Geowissenschaften/EXCISS/mechanical design/PSU/PSU_PCB.jpg

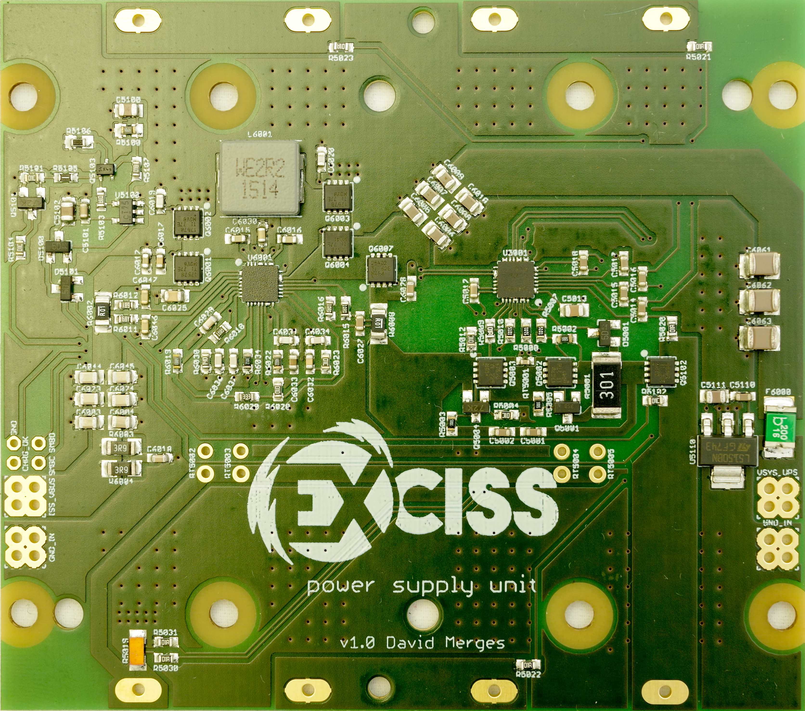
mechanical design/PSU/PSU_PCB.jpg
