Geowissenschaften/EXCISS/mechanical design/Mainboard/MB_PCB_bottom.jpg

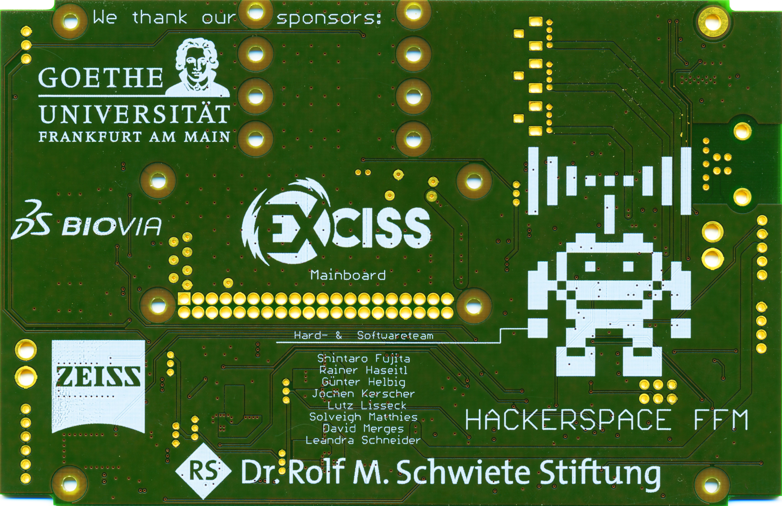
mechanical design/Mainboard/MB_PCB_bottom.jpg
