Geowissenschaften/EXCISS/README.md

# EXCISS
Experimental Chondrule Formation at the International Space Station 

Documentation is still beeing updated.

The circuit design files are online, the mechanical design files will be next.
