Geowissenschaften/EXCISS/mechanical design/HVU/HVU_PCB_trigger_back.jpg

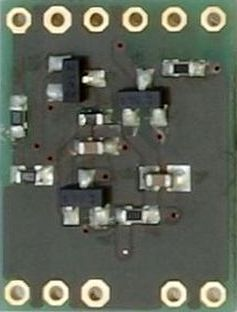
mechanical design/HVU/HVU_PCB_trigger_back.jpg
