Geowissenschaften/EXCISS/mechanical design/HVU/HVU_PCB_trigger_front.jpg

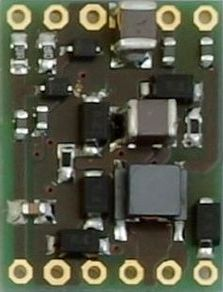
mechanical design/HVU/HVU_PCB_trigger_front.jpg
