Geowissenschaften/EXCISS/mechanical design/Mainboard/MB_PCB_top.jpg

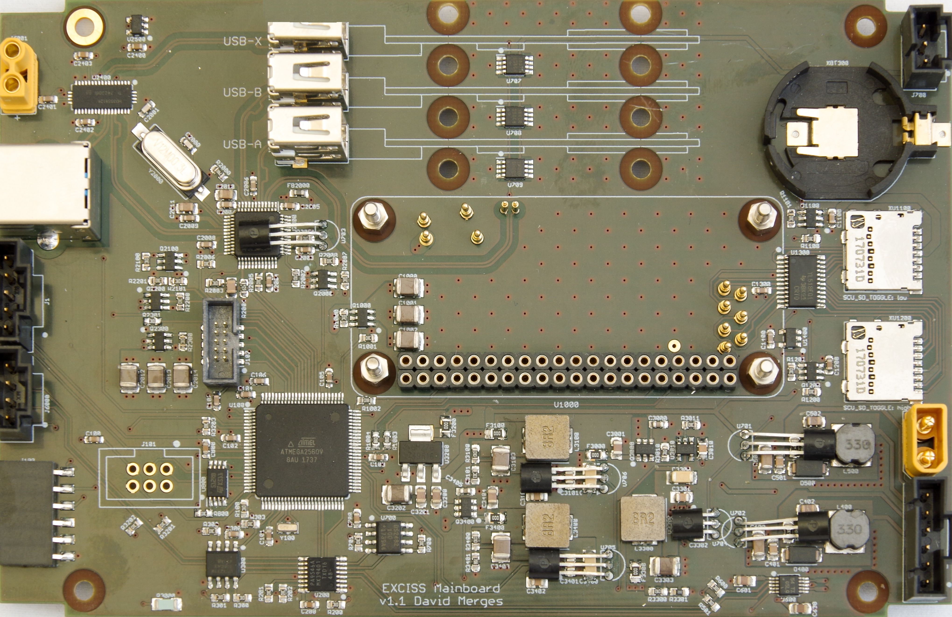
mechanical design/Mainboard/MB_PCB_top.jpg
