Geowissenschaften/EXCISS/mechanical design/SEU/SEU_Raspberry_Camera_V2.1.png

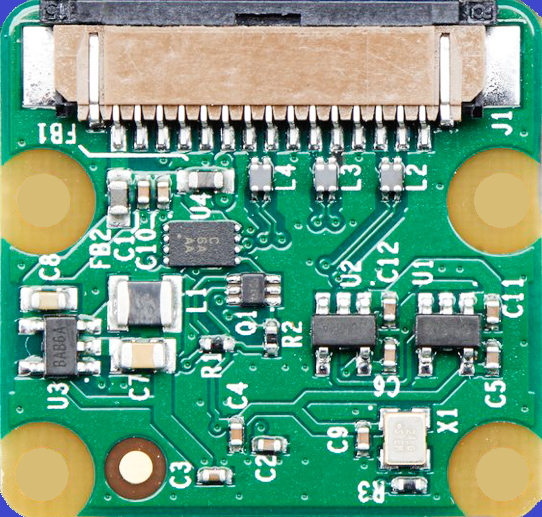
mechanical design/SEU/SEU_Raspberry_Camera_V2.1.png
