Geowissenschaften/EXCISS/(list of files, cad)

Other CAD files:
mechanical design/HVU/HVU.iam
mechanical design/HVU/HVU_1N4007.ipt
mechanical design/HVU/HVU_DC_DC_converter_(M1730CQEA06065).ipt
mechanical design/HVU/HVU_DIN_934_M3x0,5.ipt
mechanical design/HVU/HVU_PCB_power_switch.ipt
mechanical design/HVU/HVU_PCB_trigger.ipt
mechanical design/HVU/HVU_PTFE_sleeve.ipt
mechanical design/HVU/HVU_capacitor_150µF_(LGN2X151MELB50).ipt
mechanical design/HVU/HVU_capacitor_MKP4_0,1µF_(450377).ipt
mechanical design/HVU/HVU_conductor.ipt
mechanical design/HVU/HVU_diode_(BY16).ipt
mechanical design/HVU/HVU_dust.ipt
mechanical design/HVU/HVU_elekrode_tip_r.ipt
mechanical design/HVU/HVU_elekrode_tip_t.ipt
mechanical design/HVU/HVU_elektrode_Cu.ipt
mechanical design/HVU/HVU_ferrit_cable_core_(28B0773-050).ipt
mechanical design/HVU/HVU_ignition_coil.ipt
mechanical design/HVU/HVU_ignition_coil_stud.ipt
mechanical design/HVU/HVU_resistor_1M5_(VR25000001504JA100).ipt
mechanical design/HVU/HVU_resistor_2M2_(VR25000002204JA100).ipt
mechanical design/HVU/HVU_resistor_5M1_(VR25000005104JA100).ipt
mechanical design/HVU/HVU_resistor_WHS7_68R.ipt
mechanical design/HVU/HVU_sample_chamber.iam
mechanical design/HVU/HVU_sample_chamber.ipt
mechanical design/HVU/HVU_sample_chamber_dummy.ipt
mechanical design/HVU/HVU_sample_chamber_half.iam
mechanical design/HVU/HVU_sample_chamber_half.ipt
mechanical design/HVU/HVU_sample_chamber_mount_minus.ipt
mechanical design/HVU/HVU_sample_chamber_mount_plus.ipt
mechanical design/HVU/HVU_schunt.ipt
mechanical design/HVU/HVU_spark.ipt
mechanical design/HVU/HVU_standoff_(DA_40MM).ipt
mechanical design/HVU/HVU_thyristor(TN2540-800G-TR).ipt
mechanical design/HVU/HVU_wires_Carc.ipt
mechanical design/HVU/HVU_wires_Darc.ipt
mechanical design/HVU/HVU_wires_diodes.ipt
mechanical design/HVU/HVU_wires_resistor.ipt
mechanical design/HVU/HVU_wires_resistor_WHS7.ipt
mechanical design/Mainboard/MB_DIN_934_M2,5.ipt
mechanical design/Mainboard/MB_DIN_EN_ISO_1207_M2,5x6.ipt
mechanical design/Mainboard/MB_Keystone_1070.ipt
mechanical design/Mainboard/MB_MOLEX_705430002.ipt
mechanical design/Mainboard/MB_MOLEX_705430003.ipt
mechanical design/Mainboard/MB_MOLEX_705430004.ipt
mechanical design/Mainboard/MB_MOLEX_705430005.ipt
mechanical design/Mainboard/MB_RaspberryPiZeroW.ipt
mechanical design/Mainboard/MB_USB_3B_connector.ipt
mechanical design/Mainboard/MB_USB_A_B.ipt
mechanical design/Mainboard/MB_USB_X.ipt
mechanical design/Mainboard/MB_USB_connector.ipt
mechanical design/Mainboard/MB_USB_heatspreader_1.ipt
mechanical design/Mainboard/MB_USB_heatspreader_2.ipt
mechanical design/Mainboard/MB_XT30U_female_(1460539 ).ipt
mechanical design/Mainboard/MB_XT30U_male_(1460540).ipt
mechanical design/Mainboard/MB_standoff_(1466814)_shortend.ipt
mechanical design/NanoLab/NanoLab_CubeDeckel_1.ipt
mechanical design/NanoLab/NanoLab_CubeDeckel_2.ipt
mechanical design/PSU/PSU_18650_Cu_spacer.ipt
mechanical design/PSU/PSU_AS_1427_M3x5.ipt
mechanical design/PSU/PSU_PCB.ipt
mechanical design/PSU/PSU_battery_retaining_plate.ipt
mechanical design/PSU/PSU_dual_THM_battery_holder_long.ipt
mechanical design/PSU/PSU_standoff_(DA_5MM).ipt
mechanical design/PSU/PSU_standoff_(DI_20MM).ipt
mechanical design/SEU/SEU.iam
mechanical design/SEU/SEU_LINOS_Microbench_rod_(G061210000).ipt
mechanical design/SEU/SEU_Luxeon_Rebel_Star_backlight.ipt
mechanical design/SEU/SEU_Luxeon_Rebel_Star_frontlight.ipt
mechanical design/SEU/SEU_Raspberry_Camera_V2.1.ipt
mechanical design/SEU/SEU_ZEISS_EC_Epiplan-Neofluar_(422320-9900-000).ipt
mechanical design/SEU/SEU_ZEISS_tubus_lense_(423606-8031).ipt
mechanical design/SEU/SEU_backlight_diffusor_ppma.ipt
mechanical design/SEU/SEU_camera_mount_(G061008000).ipt
mechanical design/SEU/SEU_led_mount_backlight_(G061008000).ipt
mechanical design/SEU/SEU_led_mount_frontlight.ipt
mechanical design/SEU/SEU_lense_mount_(G061042000).ipt
mechanical design/SEU/SEU_mounting_fixture_back(G061042000).ipt
mechanical design/SEU/SEU_mounting_fixture_front(G061042000).ipt
mechanical design/SEU/SEU_retaining_plate_HVU.ipt
mechanical design/SEU/SEU_threaded_insert_M3.ipt
mechanical design/SEU/SEU_threaded_insert_insulation.ipt
mechanical design/Screws/ANSI_4-40_UNC.ipt
mechanical design/Screws/DIN_963_M2,5x5.ipt
mechanical design/Screws/DIN_963_M3x5.ipt
mechanical design/Screws/DIN_963_M3x6.ipt
