Geowissenschaften/EXCISS/PCB/EXCISS HVU.pdf

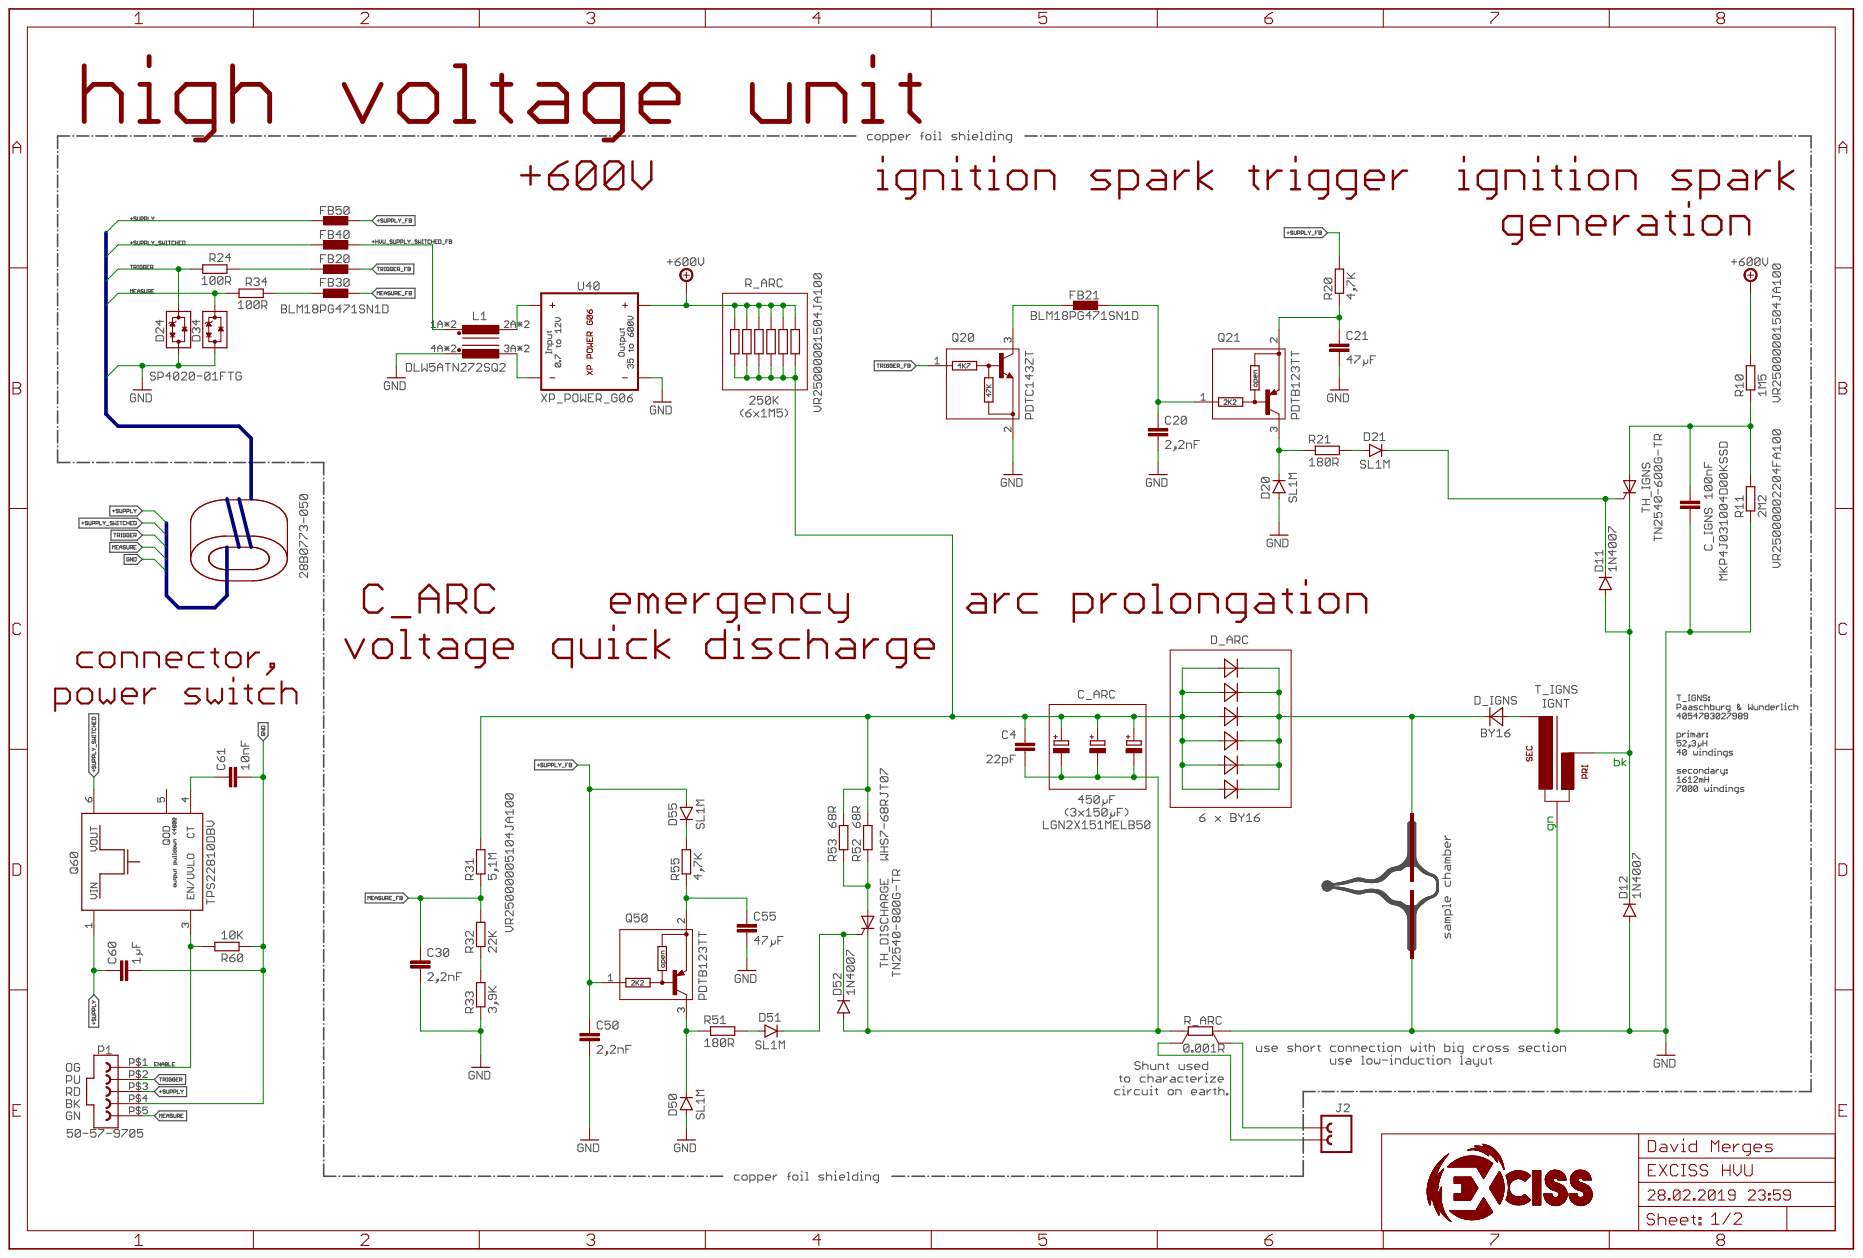
[picture p7: page 1]
