Geowissenschaften/EXCISS/PCB/EXCISS PSU.pdf

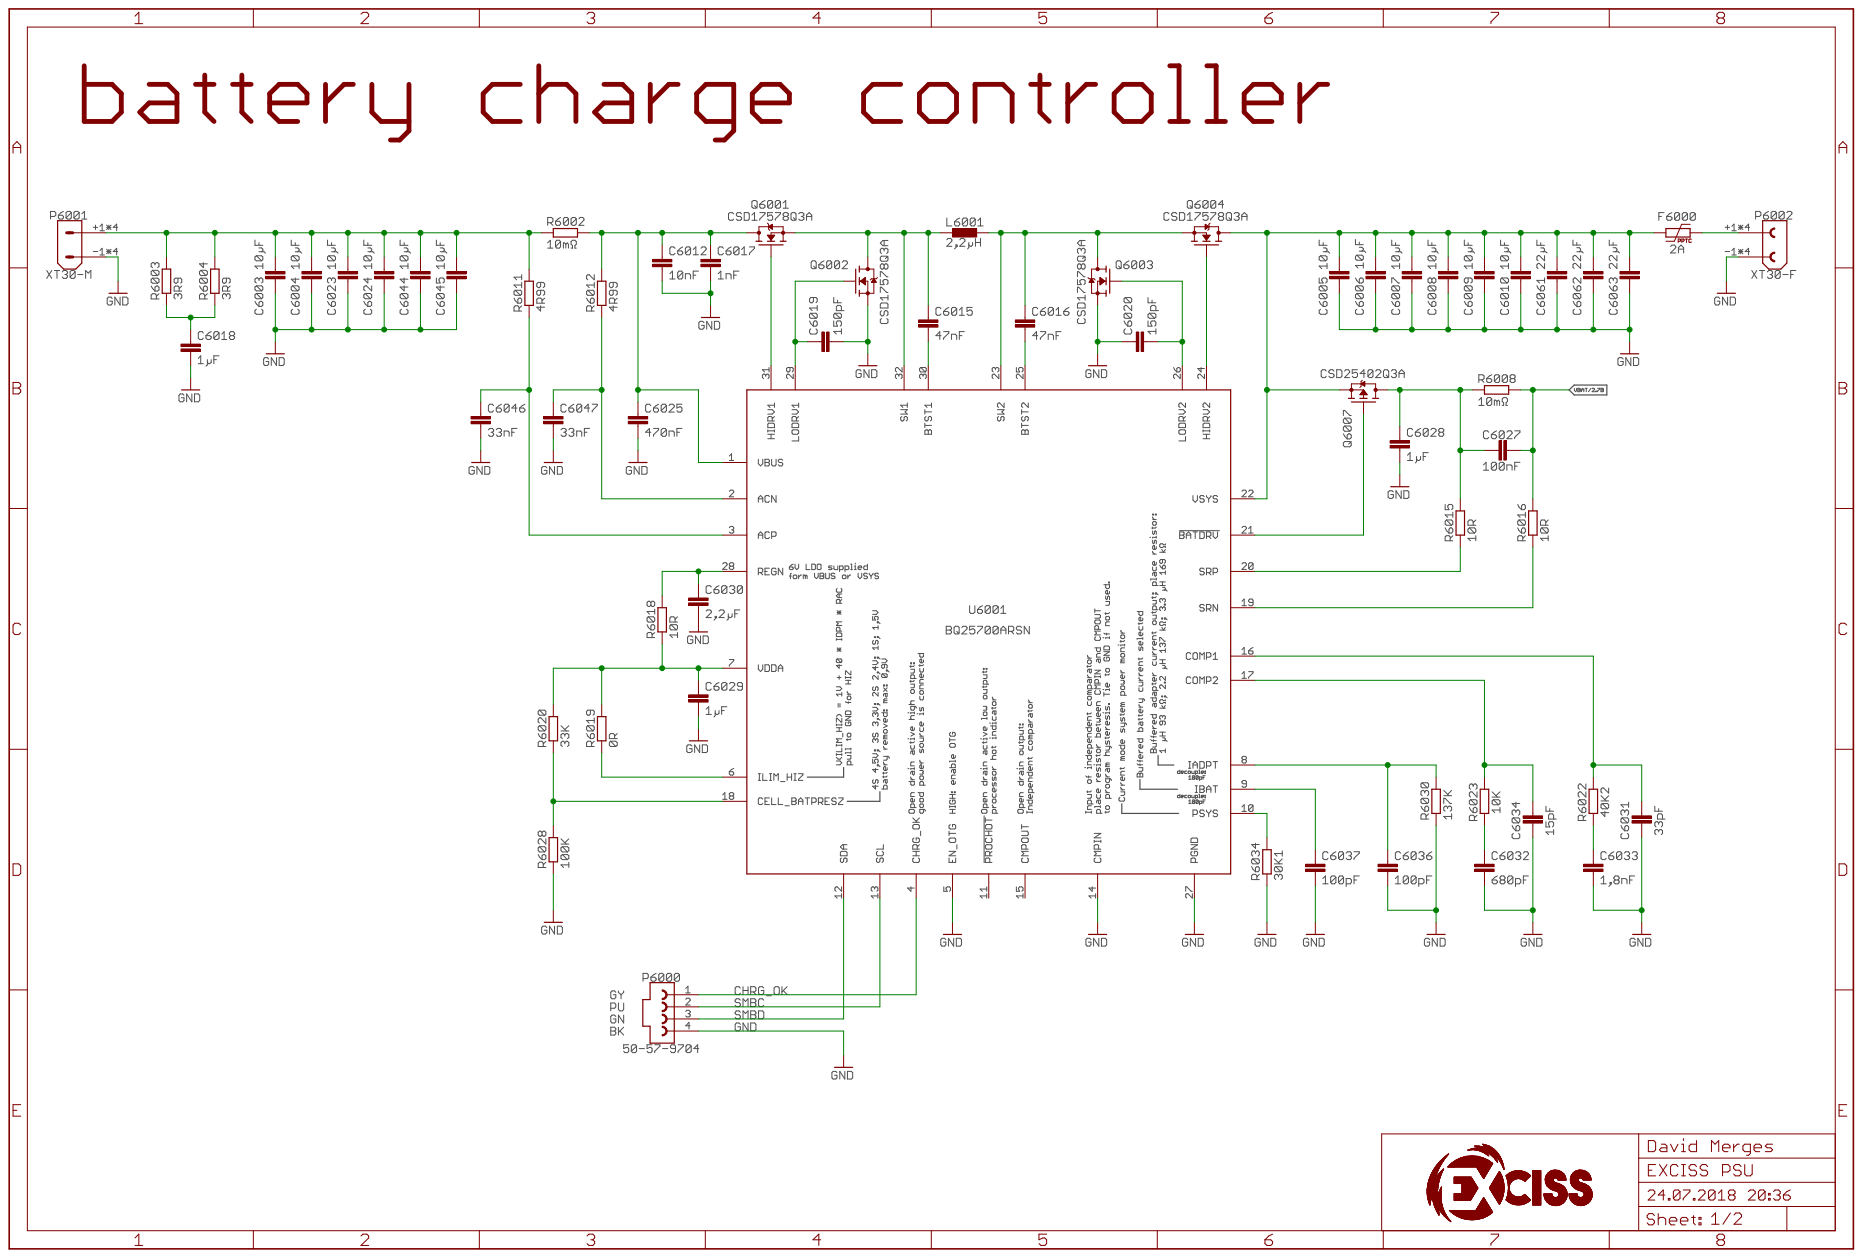
[picture p13: page 1]

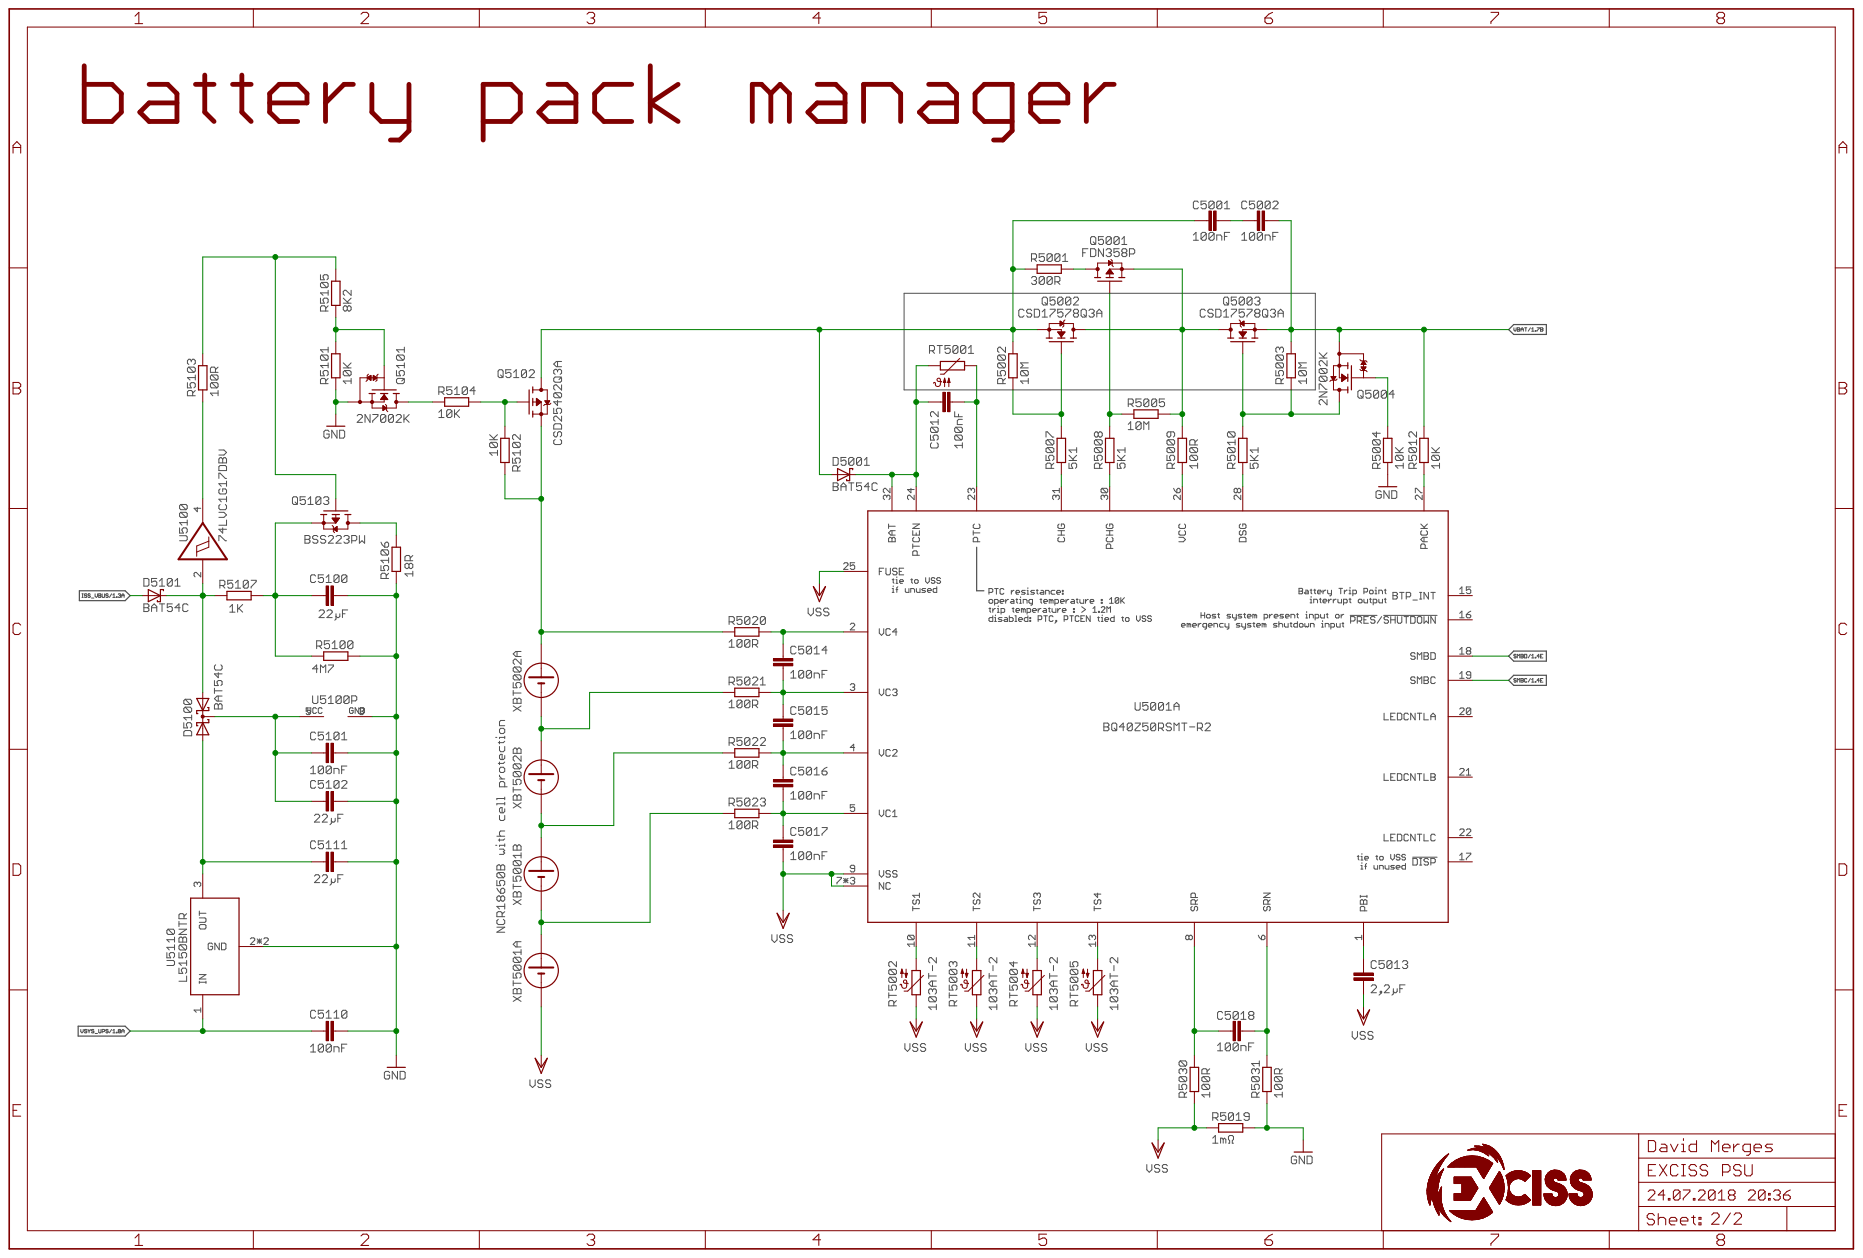
[picture p14: page 2]
