Geowissenschaften/EXCISS/PCB/EXCISS SEU.pdf

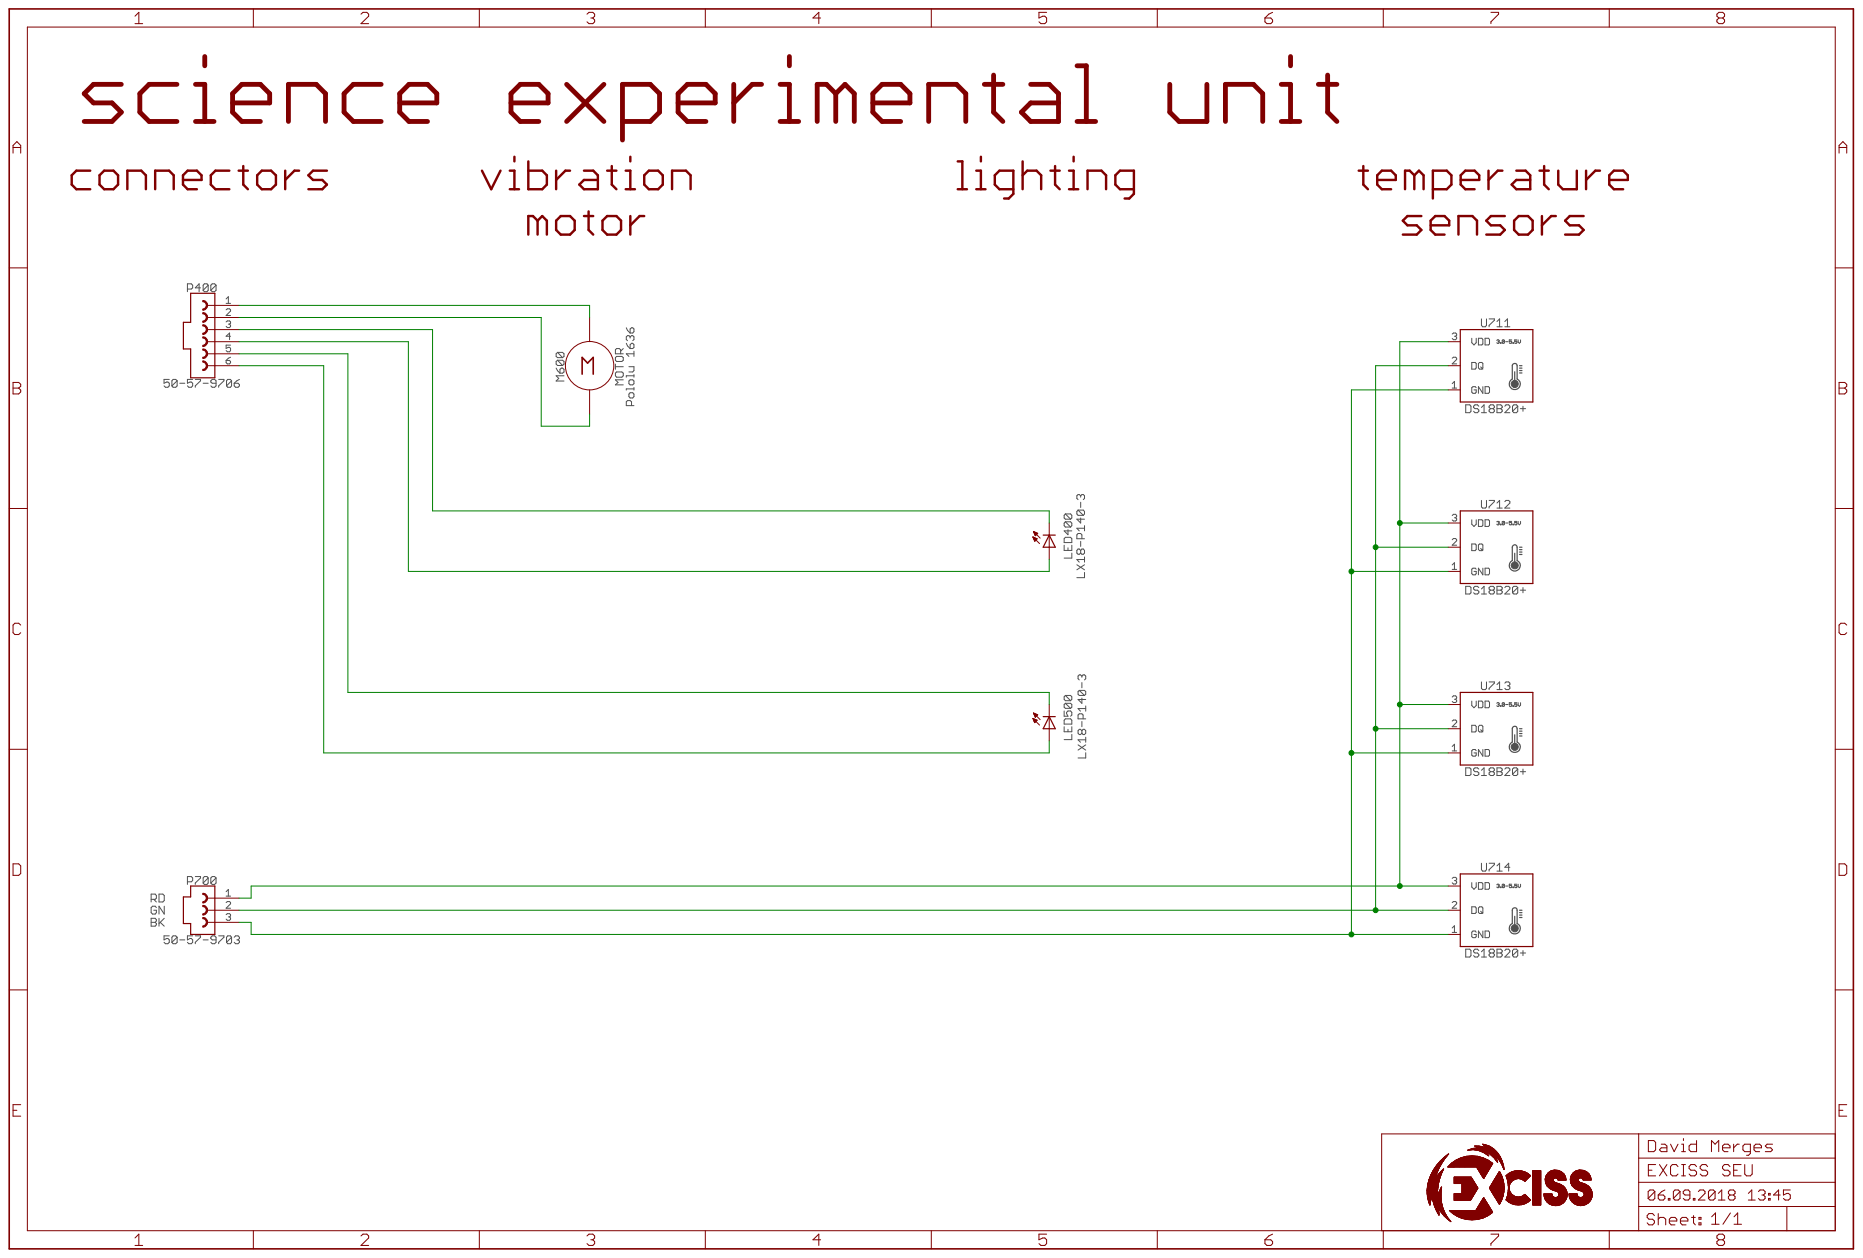
[picture p15: page 1]
