Geowissenschaften/EXCISS/PCB/EXCISS PSU.brd

## EAGLE design PCB/EXCISS PSU.brd (2019-06-11)

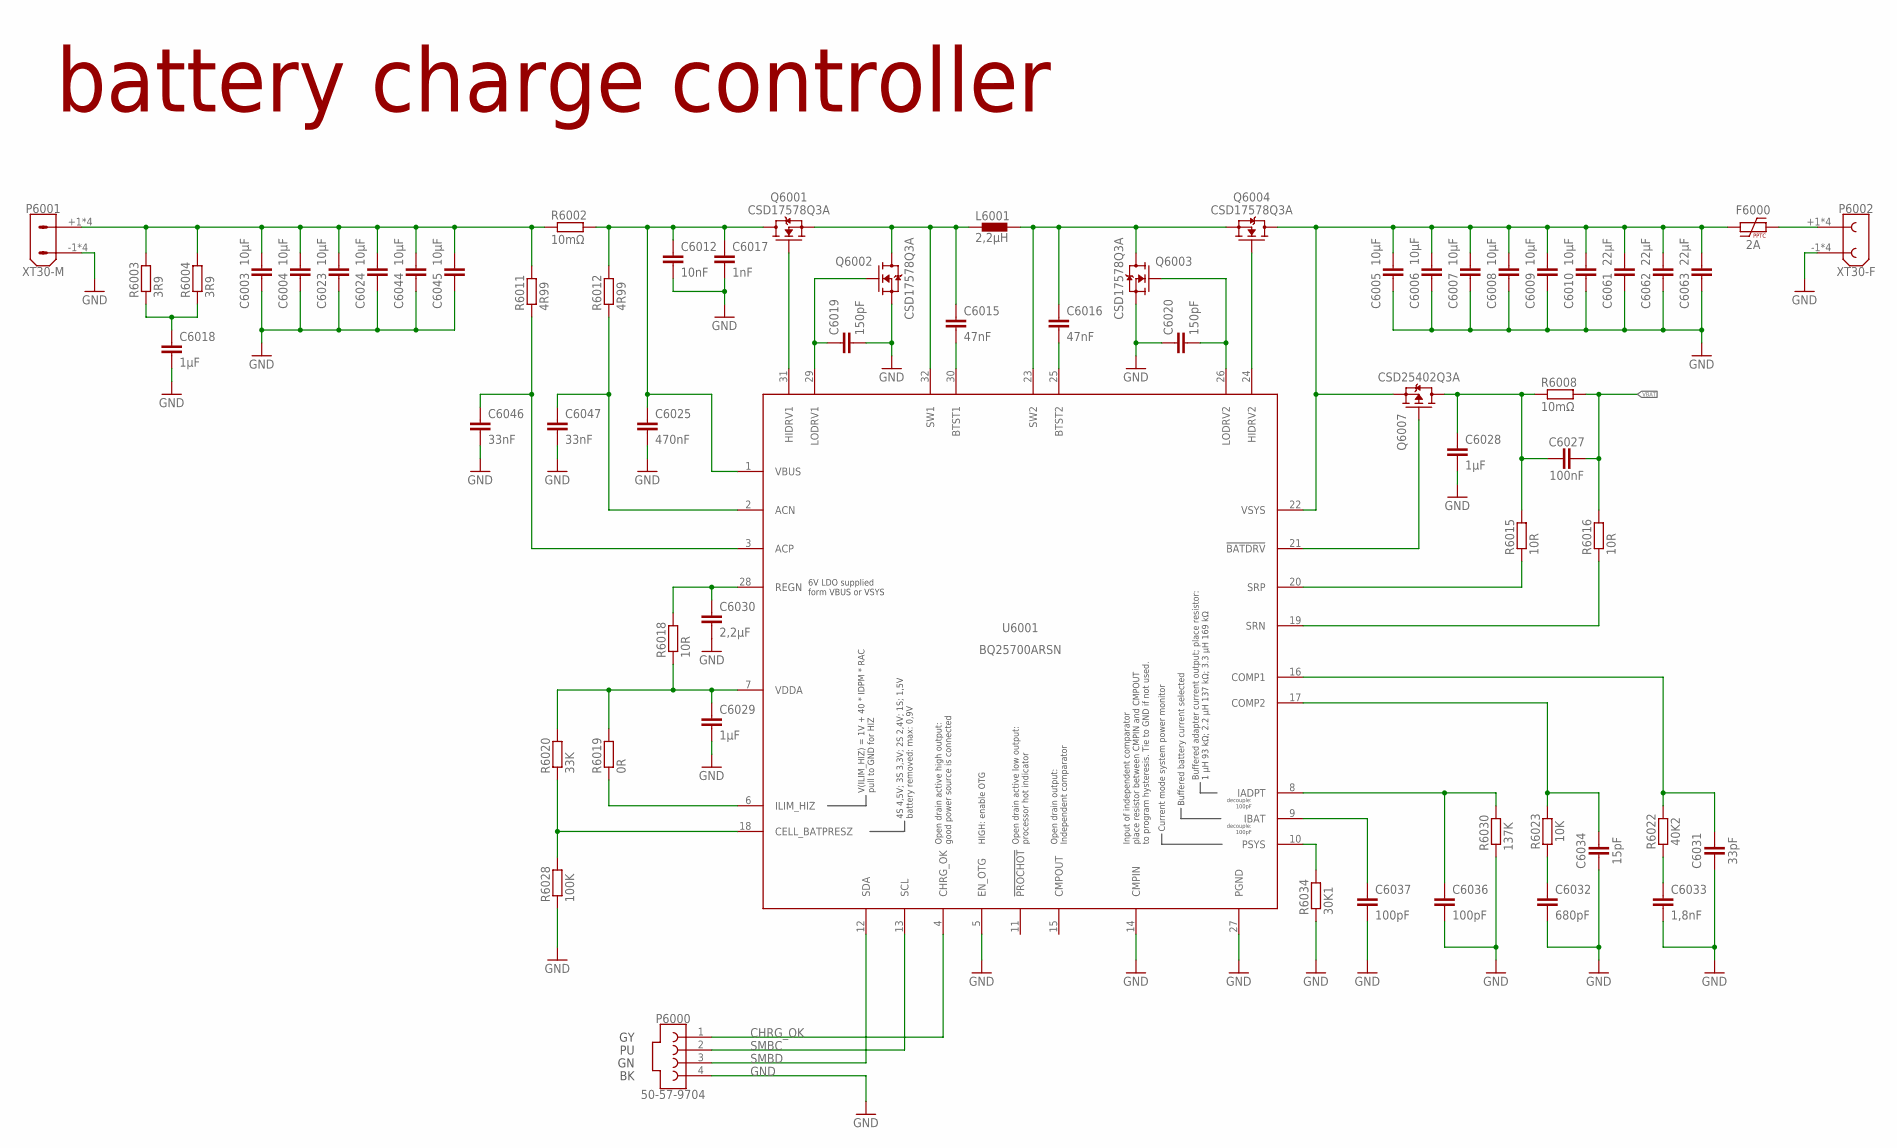
[picture p16: schematic EXCISS PSU.sch, sheet 1]

Parts:
C6003, C6004, C6005, C6006, C6007, C6008, C6009, C6010, C6023, C6024, C6044, C6045: 10µF; C0805
C6012: 10nF; C0603
C6015, C6016: 47nF; C0603
C6017: 1nF; C0603
C6018, C6028, C6029: 1µF; C0603
C6019, C6020: 150pF; C0603
C6025: 470nF; C0805
C6027: 100nF; C0603
C6030: 2,2µF; C0603
C6031: 33pF; C0603
C6032: 680pF; C0603
C6033: 1,8nF; C0603
C6034: 15pF; C0603
C6036, C6037: 100pF; C0603
C6046, C6047: 33nF; C0603
C6061, C6062, C6063: 22µF; C1210
F6000: 2A; PTC_1812
L6001: 2,2µH; 8030
P6000: 50-57-9704; RENAME-SIGNAL
P6001: XT30-M; RENAME_XT-CONNECTOR
P6002: XT30-F; RENAME_XT-CONNECTOR
Q6001, Q6002, Q6003, Q6004: CSD17578Q3A; Q3A
Q6007: CSD25402Q3A; Q3A
R6002, R6008: 10mΩ; R1206
R6003, R6004: 3R9; R1206
R6011, R6012: 4R99; R0603
R6015, R6016, R6018: 10R; R0603
R6019: 0R; R0603
R6020: 33K; R0603
R6022: 40K2; R0603
R6023: 10K; R0603
R6028: 100K; R0603
R6030: 137K; R0603
R6034: 30K1; R0603
U6001: BQ25700ARSN; RSN(S-PWQFN-N32)

Connections:
CHRG_OK: P6000.1, U6001.4 (CHRG_OK)
GND: C6003.2, C6004.2, C6005.2, C6006.2, C6007.2, C6008.2, C6009.2, C6010.2, C6012.2, C6017.2, C6018.2, C6019.2, C6020.1, C6023.2, C6024.2, C6025.2, C6028.2, C6029.2, C6030.2, C6031.2, C6032.2, C6033.2, C6034.2, C6036.2, C6037.2, C6044.2, C6045.2, C6046.2, C6047.2, C6061.2, C6062.2, C6063.2, P6000.4, P6001.-1 (-), P6001.-2 (-), P6001.-3 (-), P6001.-4 (-), P6002.-1 (-), P6002.-2 (-), P6002.-3 (-), P6002.-4 (-), Q6002.1 (S), Q6002.2 (S), Q6002.3 (S), Q6003.1 (S), Q6003.2 (S), Q6003.3 (S), R6028.1, R6030.1, R6034.1, U6001.5 (EN_OTG), U6001.14 (CMPIN), U6001.27 (PGND), U6001.TP0 (GND), U6001.TP1 (GND), U6001.TP2 (GND), U6001.TP3 (GND), U6001.TP4 (GND), U6001.TP5 (GND), U6001.TP6 (GND), U6001.TP7 (GND), U6001.TP8 (GND), U6001.TP9 (GND); also elsewhere on the board
ISS_VBUS: C6003.1, C6004.1, C6023.1, C6024.1, C6044.1, C6045.1, P6001.+1 (+), P6001.+2 (+), P6001.+3 (+), P6001.+4 (+), R6002.1, R6003.2, R6004.2, R6011.2; also elsewhere on the board
unnamed: C6018.1, R6003.1, R6004.1
unnamed: Q6007.4 (G), U6001.21 (!BATDRV)
unnamed: C6032.1, R6023.1
unnamed: R6015.1, U6001.20 (SRP)
unnamed: C6027.1, C6028.1, Q6007.1 (D), Q6007.2 (D), Q6007.3 (D), R6008.1, R6015.2
unnamed: R6016.1, U6001.19 (SRN)
unnamed: Q6001.4 (G), U6001.31 (HIDRV1)
unnamed: C6019.1, Q6002.4 (G), U6001.29 (LODRV1)
unnamed: C6015.2, U6001.30 (BTST1)
unnamed: C6016.1, L6001.P$2 (2), Q6003.TP0 (D), Q6003.TP1 (D), Q6003.TP2 (D), Q6003.TP3 (D), Q6003.TP4 (D), Q6003.TP5 (D), Q6003.TP6 (D), Q6003.TP7 (D), Q6004.1 (S), Q6004.2 (S), Q6004.3 (S), U6001.23 (SW2)
unnamed: C6034.1, R6023.2, U6001.17 (COMP2)
unnamed: C6036.1, R6030.2, U6001.8 (IADPT)
unnamed: R6019.1, U6001.6 (ILIM_HIZ)
unnamed: C6033.1, R6022.1
unnamed: C6020.2, Q6003.4 (G), U6001.26 (LODRV2)
unnamed: Q6004.4 (G), U6001.24 (HIDRV2)
unnamed: C6031.1, R6022.2, U6001.16 (COMP1)
unnamed: C6015.1, L6001.P$1 (1), Q6001.1 (S), Q6001.2 (S), Q6001.3 (S), Q6002.TP0 (D), Q6002.TP1 (D), Q6002.TP2 (D), Q6002.TP3 (D), Q6002.TP4 (D), Q6002.TP5 (D), Q6002.TP6 (D), Q6002.TP7 (D), U6001.32 (SW1)
unnamed: R6034.2, U6001.10 (PSYS)
unnamed: C6037.1, U6001.9 (IBAT)
unnamed: C6046.1, R6011.1, U6001.3 (ACP)
unnamed: C6047.1, R6012.1, U6001.2 (ACN)
unnamed: C6016.2, U6001.25 (BTST2)
unnamed: C6012.1, C6017.1, C6025.1, Q6001.TP0 (D), Q6001.TP1 (D), Q6001.TP2 (D), Q6001.TP3 (D), Q6001.TP4 (D), Q6001.TP5 (D), Q6001.TP6 (D), Q6001.TP7 (D), R6002.2, R6012.2, U6001.1 (VBUS)
unnamed: R6020.1, R6028.2, U6001.18 (CELL_BATPRESZ)
REGN: C6030.1, R6018.2, U6001.28 (REGN)
SMBC: P6000.2, U6001.13 (SCL); also elsewhere on the board
SMBD: P6000.3, U6001.12 (SDA); also elsewhere on the board
VBAT: C6027.2, R6008.2, R6016.2; also elsewhere on the board
VDDA: C6029.1, R6018.1, R6019.2, R6020.2, U6001.7 (VDDA)
VSYS_UPS: F6000.P$3 (2), P6002.+1 (+), P6002.+2 (+), P6002.+3 (+), P6002.+4 (+); also elsewhere on the board
VSYS_UPS_PREFUSE: C6005.1, C6006.1, C6007.1, C6008.1, C6009.1, C6010.1, C6061.1, C6062.1, C6063.1, F6000.P$2 (1), Q6004.TP0 (D), Q6004.TP1 (D), Q6004.TP2 (D), Q6004.TP3 (D), Q6004.TP4 (D), Q6004.TP5 (D), Q6004.TP6 (D), Q6004.TP7 (D), Q6007.TP0 (S), Q6007.TP1 (S), Q6007.TP2 (S), Q6007.TP3 (S), Q6007.TP4 (S), Q6007.TP5 (S), Q6007.TP6 (S), Q6007.TP7 (S), U6001.22 (VSYS)

Notes on the sheet:
battery charge controller

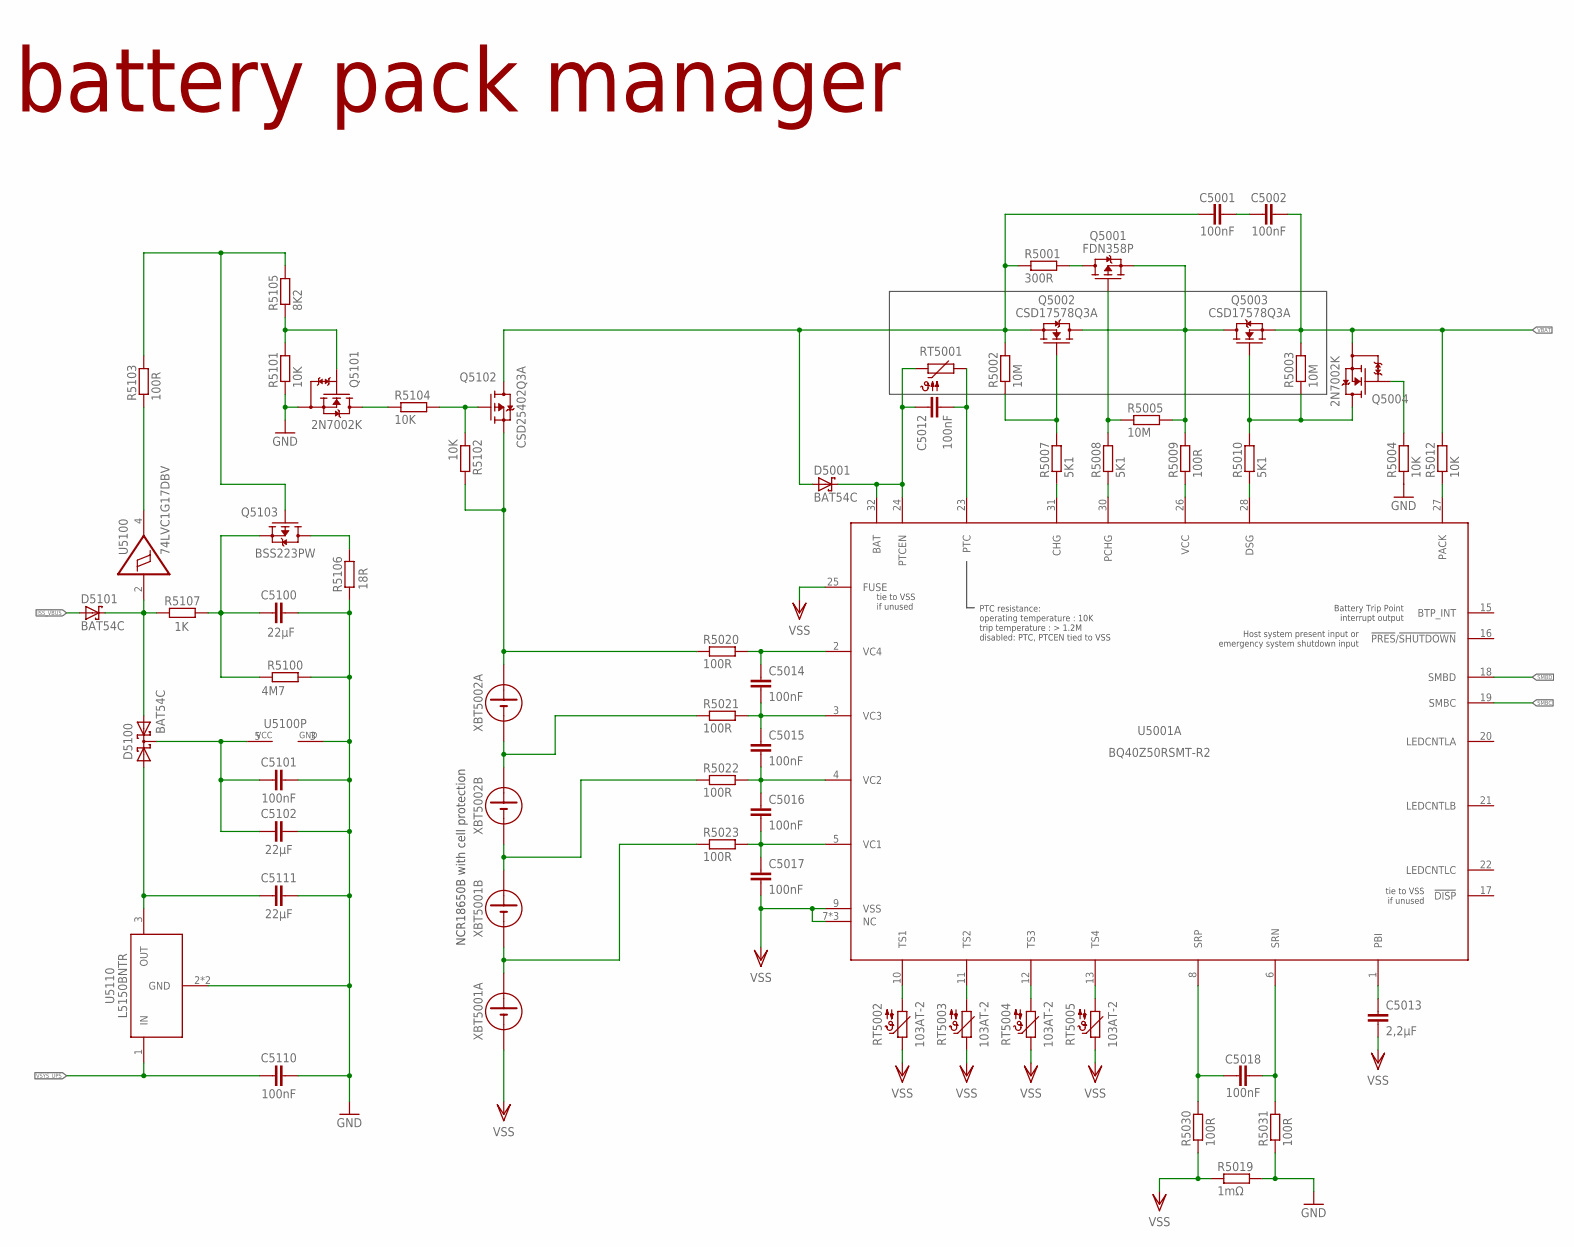
[picture p17: schematic EXCISS PSU.sch, sheet 2]

Parts:
C5001, C5002, C5012, C5014, C5015, C5016, C5017, C5018, C5101, C5110: 100nF; C0603
C5013: 2,2µF; C0805
C5100, C5102, C5111: 22µF; C0805
D5001, D5100, D5101: BAT54C; SOT23
Q5001: FDN358P; SOT23-3
Q5002, Q5003: CSD17578Q3A; Q3A
Q5004, Q5101: 2N7002K; SOT23-3
Q5102: CSD25402Q3A; Q3A
Q5103: BSS223PW; DCK(R-PDSO-G3)
R5001: 300R; R2512
R5002, R5003, R5005: 10M; R0603
R5004, R5012, R5101, R5102, R5104: 10K; R0603
R5007, R5008, R5010: 5K1; R0603
R5009, R5020, R5021, R5022, R5023, R5030, R5031, R5103: 100R; R0603
R5019: 1mΩ; R1206
R5100: 4M7; R0805
R5105: 8K2; R0603
R5106: 18R; R0805
R5107: 1K; R0603
RT5001: PRF15BB103RB6RC; 0402
RT5002, RT5003, RT5004, RT5005: 103AT-2; AT-2
U5001: BQ40Z50RSMT-R2; RSM(S-PVQFN-N32)
U5100: 74LVC1G17DBV; SOT23-5
U5110: L5150BNTR; SOT223
XBT5001, XBT5002: KEYSTONE_1049_LONG

Connections:
1P: R5023.1, XBT5001.1+ (+), XBT5001.2- (-)
2P: R5022.1, XBT5001.2+ (+), XBT5002.2- (-)
3P: R5021.1, XBT5002.1- (-), XBT5002.2+ (+)
4P: Q5102.TP0 (S), Q5102.TP1 (S), Q5102.TP2 (S), Q5102.TP3 (S), Q5102.TP4 (S), Q5102.TP5 (S), Q5102.TP6 (S), Q5102.TP7 (S), R5020.1, R5102.2, XBT5002.1+ (+)
4P_SWITCHED: C5001.1, D5001.1 (A), Q5002.1 (S), Q5002.2 (S), Q5002.3 (S), Q5102.1 (D), Q5102.2 (D), Q5102.3 (D), R5001.1, R5002.2
GND: C5100.2, C5101.2, C5102.2, C5110.2, C5111.2, Q5101.2 (S), R5004.1, R5019.2, R5031.1, R5100.1, R5101.1, R5106.2, U5100.3 (GND), U5110.2 (GND), U5110.4 (GND); also elsewhere on the board
ISS_VBUS: D5101.1 (A); also elsewhere on the board
unnamed: Q5102.4 (G), R5102.1, R5104.2
unnamed: R5103.1, U5100.4 (O)
unnamed: Q5101.1 (G), R5101.2, R5105.1
unnamed: Q5101.3 (D), R5104.1
unnamed: C5100.1, Q5103.2 (S), R5100.2, R5107.1
unnamed: R5010.1, U5001.28 (DSG)
unnamed: C5001.2, C5002.1
unnamed: Q5001.2 (S), Q5002.TP0 (D), Q5002.TP1 (D), Q5002.TP2 (D), Q5002.TP3 (D), Q5002.TP4 (D), Q5002.TP5 (D), Q5002.TP6 (D), Q5002.TP7 (D), Q5003.TP0 (D), Q5003.TP1 (D), Q5003.TP2 (D), Q5003.TP3 (D), Q5003.TP4 (D), Q5003.TP5 (D), Q5003.TP6 (D), Q5003.TP7 (D), R5005.2, R5009.2
unnamed: Q5103.3 (D), R5106.1
unnamed: Q5002.4 (G), R5002.1, R5007.2
unnamed: R5007.1, U5001.31 (CHG)
unnamed: Q5001.3 (D), R5001.2
unnamed: Q5001.1 (G), R5005.1, R5008.2
unnamed: R5009.1, U5001.26 (VCC)
unnamed: C5101.1, C5102.1, D5100.3 (CC), U5100.5 (VCC)
unnamed: Q5003.4 (G), Q5004.3 (D), R5003.1, R5010.2
unnamed: R5008.1, U5001.30 (PCHG)
unnamed: Q5004.1 (G), R5004.2
unnamed: R5012.1, U5001.27 (PACK)
unnamed: C5014.1, R5020.2, U5001.2 (VC4)
unnamed: C5014.2, C5015.1, R5021.2, U5001.3 (VC3)
unnamed: C5015.2, C5016.1, R5022.2, U5001.4 (VC2)
unnamed: C5016.2, C5017.1, R5023.2, U5001.5 (VC1)
unnamed: C5013.1, U5001.1 (PBI)
unnamed: C5012.1, D5001.3 (C), RT5001.1, U5001.24 (PTCEN), U5001.32 (BAT)
unnamed: C5012.2, RT5001.2, U5001.23 (PTC)
unnamed: C5018.2, R5031.2, U5001.6 (SRN)
unnamed: C5018.1, R5030.2, U5001.8 (SRP)
unnamed: RT5002.P$2 (2), U5001.10 (TS1)
unnamed: RT5003.P$2 (2), U5001.11 (TS2)
unnamed: RT5004.P$2 (2), U5001.12 (TS3)
unnamed: RT5005.P$2 (2), U5001.13 (TS4)
unnamed: Q5103.1 (G), R5103.2, R5105.2
unnamed: D5100.1 (A1), D5101.3 (C), R5107.2, U5100.2 (I)
OUT: C5111.1, D5100.2 (A2), U5110.3 (OUT)
SMBC: U5001.19 (SMBC); also elsewhere on the board
SMBD: U5001.18 (SMBD); also elsewhere on the board
VBAT: C5002.2, Q5003.1 (S), Q5003.2 (S), Q5003.3 (S), Q5004.2 (S), R5003.2, R5012.2; also elsewhere on the board
VSS: C5013.2, C5017.2, R5019.1, R5030.1, RT5002.P$1 (1), RT5003.P$1 (1), RT5004.P$1 (1), RT5005.P$1 (1), U5001.7 (NC), U5001.9 (VSS), U5001.14 (NC), U5001.25 (FUSE), U5001.29 (NC), U5001.TP0 (VSS), U5001.TP1 (VSS), XBT5001.1- (-)
VSYS_UPS: C5110.1, U5110.1 (IN); also elsewhere on the board

Notes on the sheet:
battery pack manager
NCR18650B with cell protection

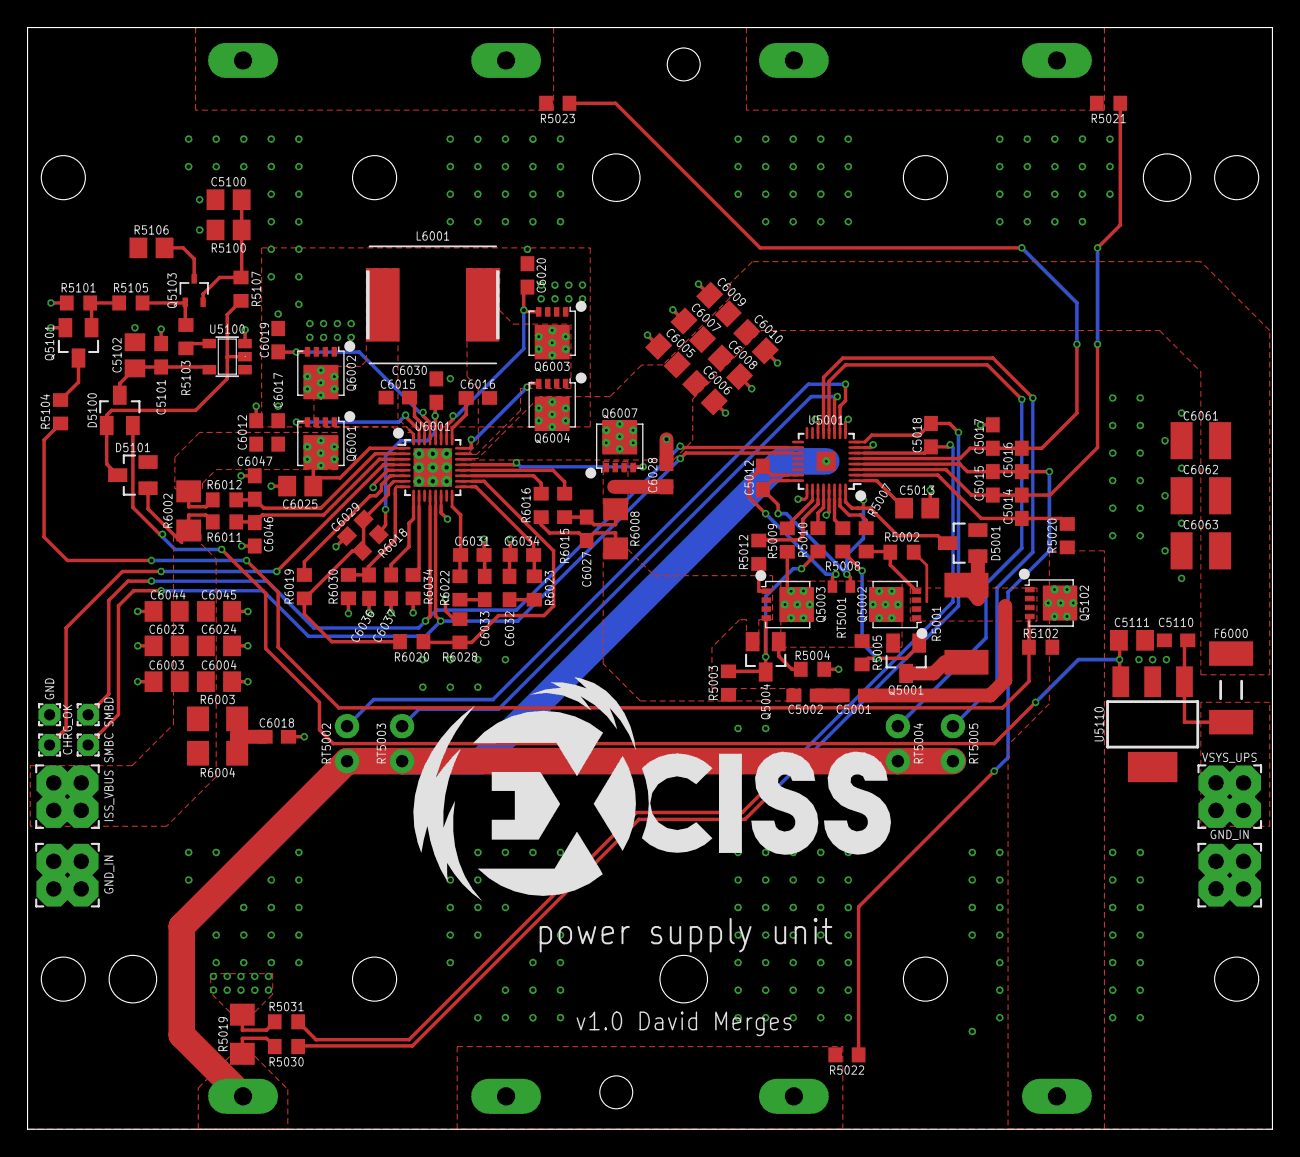
[picture p18: board EXCISS PSU.brd from above]

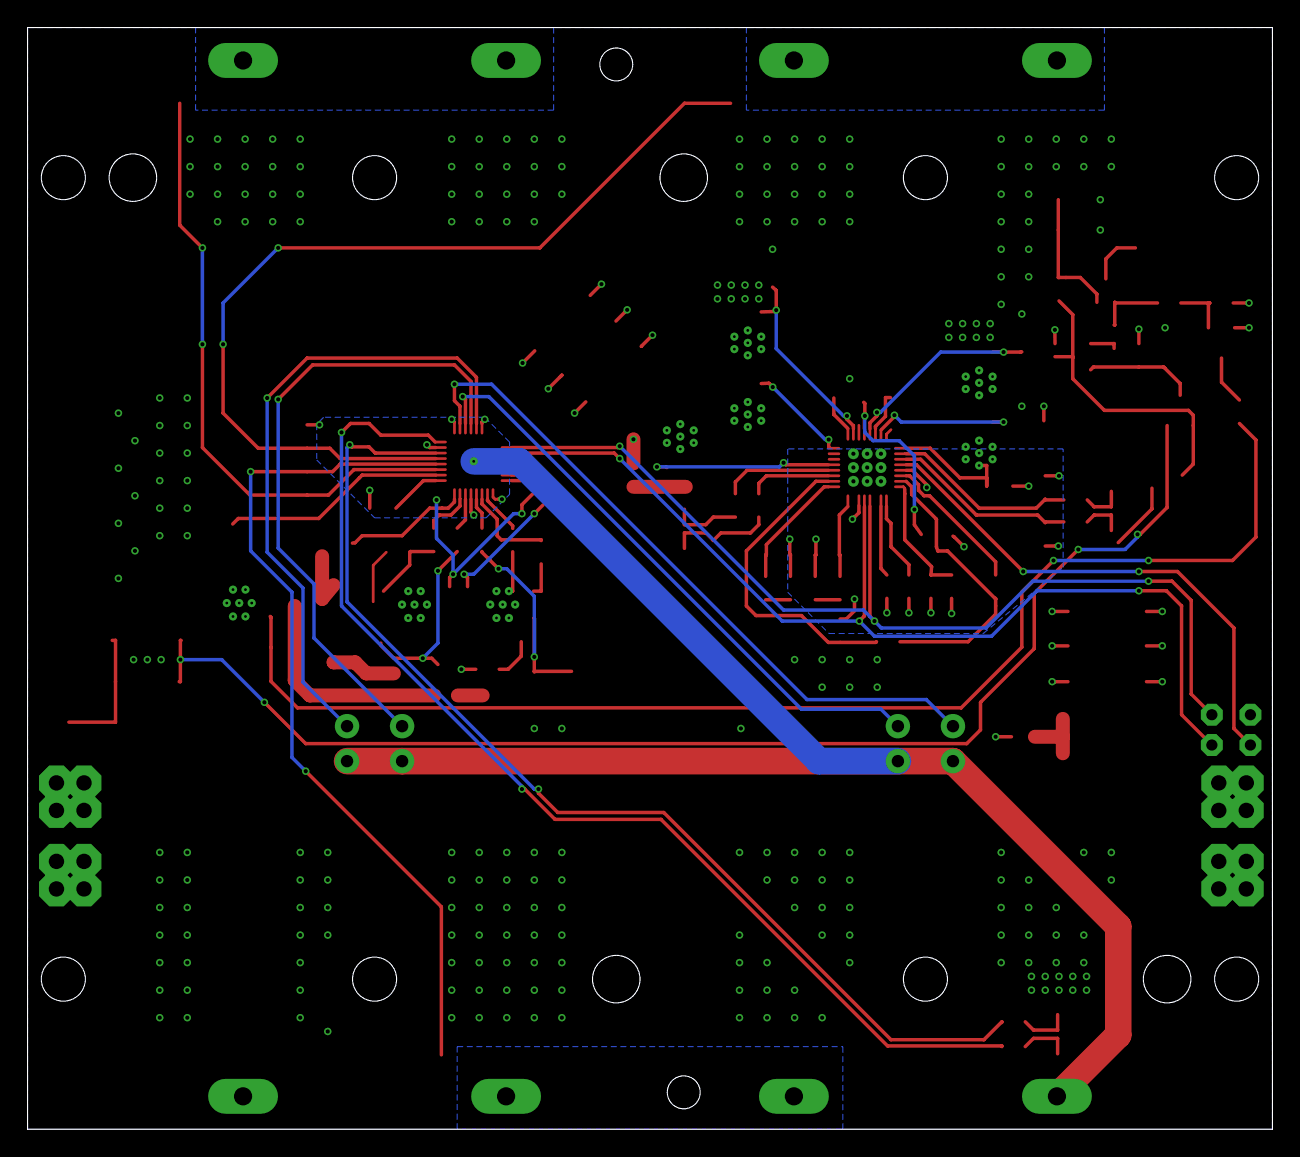
[picture p19: board EXCISS PSU.brd from below]

Board: 2 copper layers, 90.4 x 80.0 mm, 126 parts (2 on the bottom side), 76 nets.

Other parts of the board:
U$1, U$2, U$3, U$4: DRILL_M3_SPACER
U$5: LOGO_EXCISS
