Geowissenschaften/EXCISS/PCB/EXCISS Mainboard.brd

## EAGLE design PCB/EXCISS Mainboard.brd (2019-06-11)

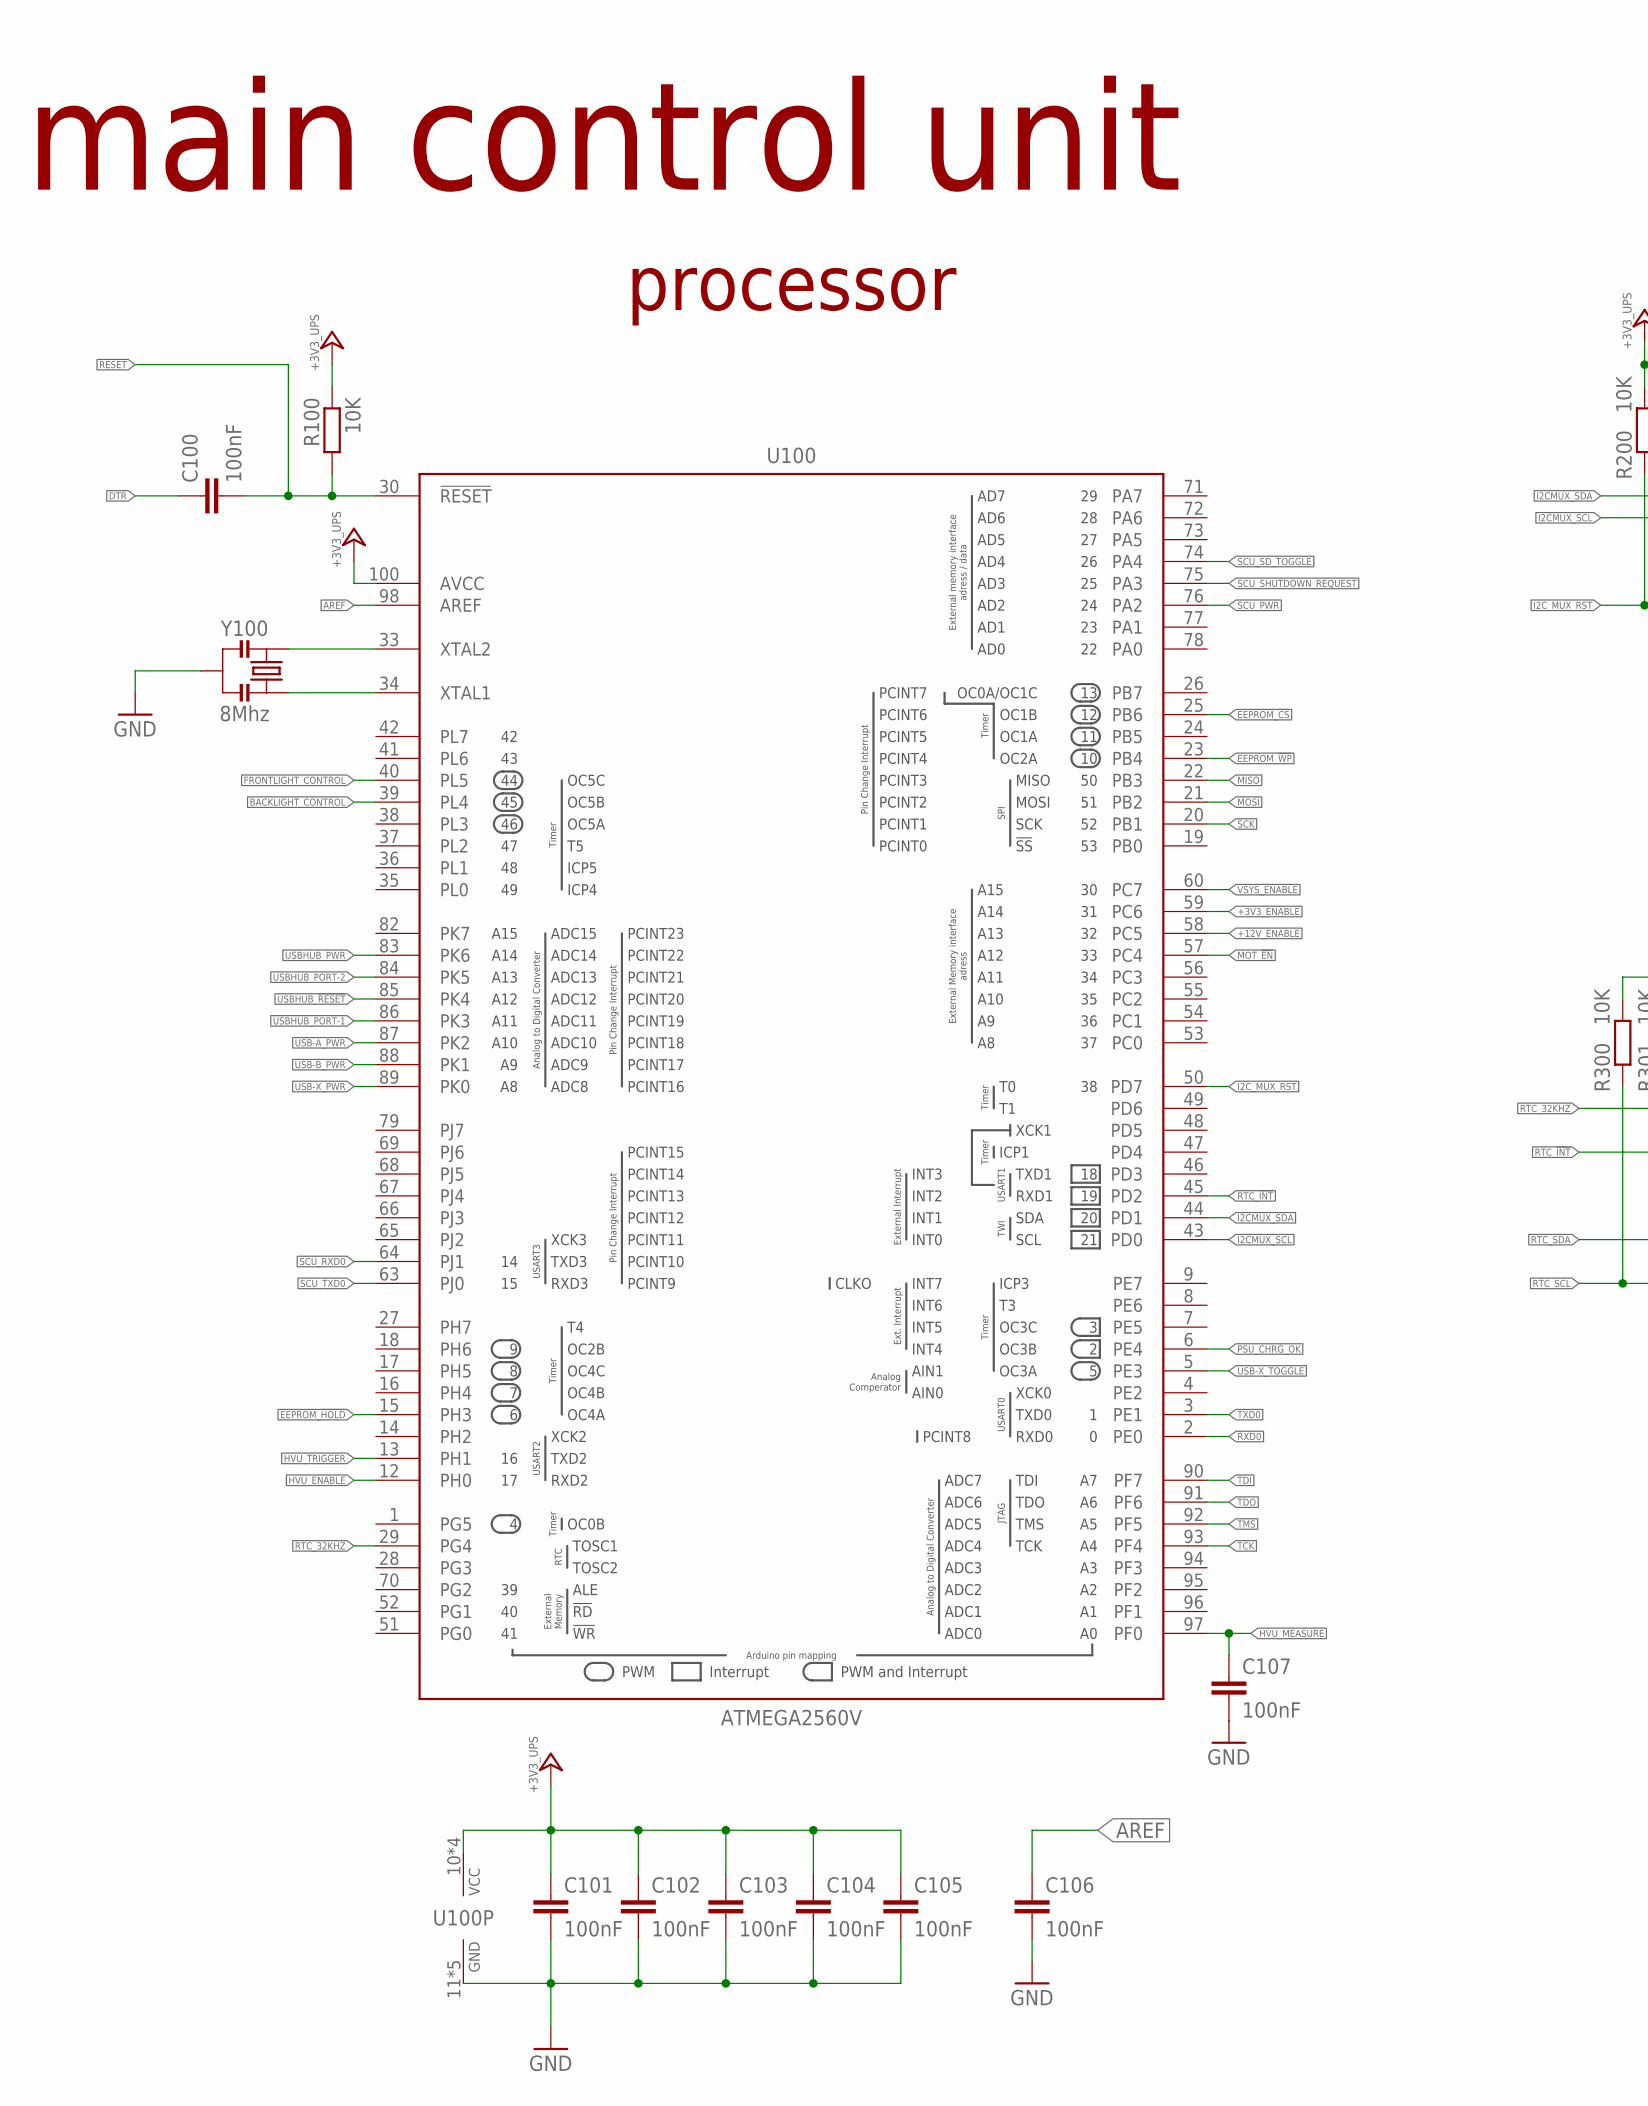
[picture p20: schematic EXCISS Mainboard.sch, sheet 1, part in row 1, column 1]

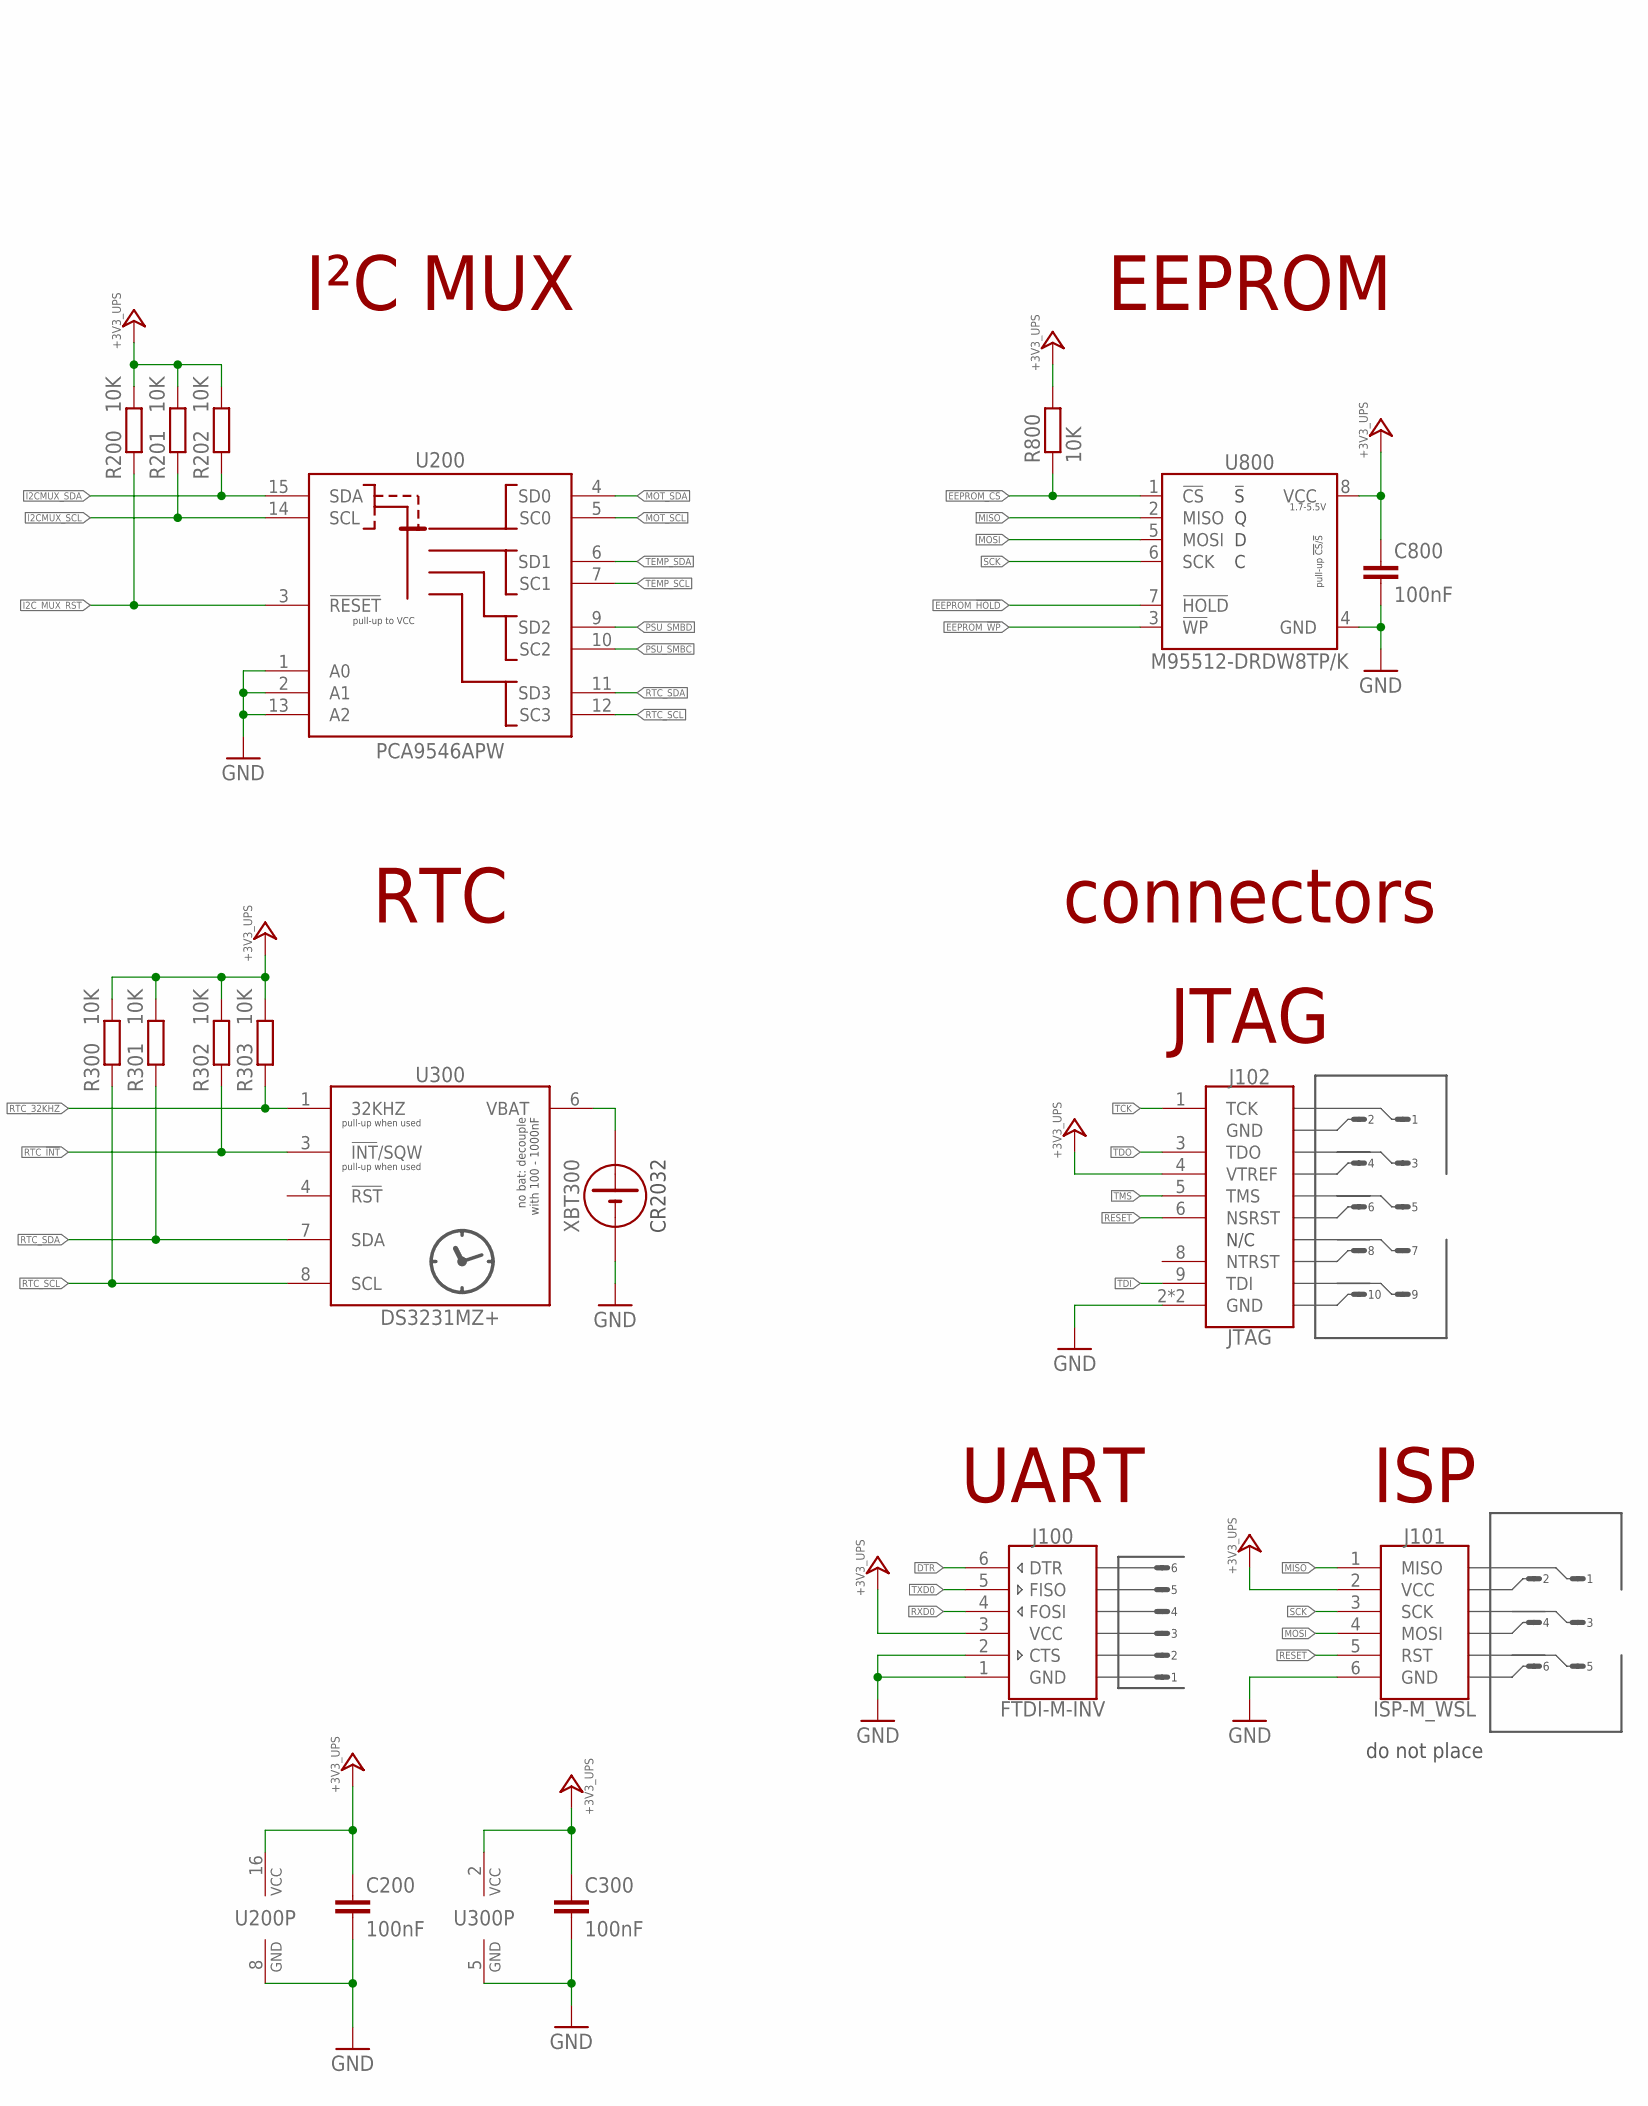
[picture p21: schematic EXCISS Mainboard.sch, sheet 1, part in row 1, column 2]

Parts:
C100, C101, C102, C103, C104, C105, C106, C107, C200, C300, C800: 100nF; C0603
J100: FTDI-M-INV; MPE_094-1-006
J101: ISP-M_WSL; ISP-M-THT
J102: JTAG; 20021521-00010T1LF
R100, R200, R201, R202, R300, R301, R302, R303, R800: 10K; R0603
U100: ATMEGA2560V; TQFP100
U200: PCA9546APW; R-PDSO-G16
U300: DS3231MZ+; SOIC8
U800: M95512-DRDW8TP/K; TSSOP8
XBT300: KEYSTONE_1070
Y100: 8Mhz; CSTNE

Connections:
+3V3_ENABLE: U100.59 (PC6); also elsewhere on the board
+3V3_UPS: C101.1, C102.1, C103.1, C104.1, C105.1, C200.1, C300.1, C800.1, J100.3 (VCC), J101.2 (VCC), J102.4 (VTREF), R100.1, R200.1, R201.1, R202.1, R300.1, R301.1, R302.1, R303.1, R800.2, U100.10 (VCC), U100.31 (VCC), U100.61 (VCC), U100.80 (VCC), U100.100 (AVCC), U200.16 (VCC), U300.2 (VCC), U800.8 (VCC); also elsewhere on the board
+12V_ENABLE: U100.58 (PC5); also elsewhere on the board
AREF: C106.1, U100.98 (AREF)
BACKLIGHT_CONTROL: U100.39 (PL4); also elsewhere on the board
DTR: C100.1, J100.6 (DTR)
EEPROM_!CS: R800.1, U100.25 (PB6), U800.1 (!CS)
EEPROM_!HOLD: U100.15 (PH3), U800.7 (!HOLD)
EEPROM_!WP: U100.23 (PB4), U800.3 (!WP)
FRONTLIGHT_CONTROL: U100.40 (PL5); also elsewhere on the board
GND: C101.2, C102.2, C103.2, C104.2, C105.2, C106.2, C107.2, C200.2, C300.2, C800.2, J100.1 (GND), J100.2 (CTS), J101.6 (GND), J102.2 (GND), J102.10 (GND), U100.11 (GND), U100.32 (GND), U100.62 (GND), U100.81 (GND), U100.99 (GND), U200.1 (A0), U200.2 (A1), U200.8 (GND), U200.13 (A2), U300.5 (GND), U800.4 (GND), XBT300.-, Y100.2; also elsewhere on the board
HVU_ENABLE: U100.12 (PH0); also elsewhere on the board
HVU_MEASURE: C107.1, U100.97 (PF0); also elsewhere on the board
HVU_TRIGGER: U100.13 (PH1); also elsewhere on the board
I2CMUX_SCL: R201.2, U100.43 (PD0), U200.14 (SCL)
I2CMUX_SDA: R202.2, U100.44 (PD1), U200.15 (SDA)
I2C_MUX_RST: R200.2, U100.50 (PD7), U200.3 (!RESET)
MISO: J101.1 (MISO), U100.22 (PB3), U800.2 (MISO)
MOSI: J101.4 (MOSI), U100.21 (PB2), U800.5 (MOSI)
MOT_!EN: U100.57 (PC4); also elsewhere on the board
MOT_SCL: U200.5 (SC0); also elsewhere on the board
MOT_SDA: U200.4 (SD0); also elsewhere on the board
unnamed: U300.6 (VBAT), XBT300.+
unnamed: U100.33 (XTAL2), Y100.1
unnamed: U100.34 (XTAL1), Y100.3
PSU_CHRG_OK: U100.6 (PE4); also elsewhere on the board
PSU_SMBC: U200.10 (SC2); also elsewhere on the board
PSU_SMBD: U200.9 (SD2); also elsewhere on the board
RESET: C100.2, J101.5 (RST), J102.6 (NSRST), R100.2, U100.30 (!RESET!)
RTC_32KHZ: R303.2, U100.29 (PG4), U300.1 (32KHZ)
RTC_!INT: R302.2, U100.45 (PD2), U300.3 (!INT!/SQW)
RTC_SCL: R300.2, U200.12 (SC3), U300.8 (SCL)
RTC_SDA: R301.2, U200.11 (SD3), U300.7 (SDA)
RXD0: J100.4 (FOSI), U100.2 (PE0)
SCK: J101.3 (SCK), U100.20 (PB1), U800.6 (SCK)
SCU_PWR: U100.76 (PA2); also elsewhere on the board
SCU_RXD0: U100.64 (PJ1); also elsewhere on the board
SCU_SD_TOGGLE: U100.74 (PA4); also elsewhere on the board
SCU_SHUTDOWN_REQUEST: U100.75 (PA3); also elsewhere on the board
SCU_TXD0: U100.63 (PJ0); also elsewhere on the board
TCK: J102.1 (TCK), U100.93 (PF4)
TDI: J102.9 (TDI), U100.90 (PF7)
TDO: J102.3 (TDO), U100.91 (PF6)
TEMP_SCL: U200.7 (SC1); also elsewhere on the board
TEMP_SDA: U200.6 (SD1); also elsewhere on the board
TMS: J102.5 (TMS), U100.92 (PF5)
TXD0: J100.5 (FISO), U100.3 (PE1)
USB-A_PWR: U100.87 (PK2); also elsewhere on the board
USB-B_PWR: U100.88 (PK1); also elsewhere on the board
USB-X_PWR: U100.89 (PK0); also elsewhere on the board
USB-X_TOGGLE: U100.5 (PE3); also elsewhere on the board
USBHUB_!RESET: U100.85 (PK4); also elsewhere on the board
USBHUB_PORT-1: U100.86 (PK3); also elsewhere on the board
USBHUB_PORT-2: U100.84 (PK5); also elsewhere on the board
USBHUB_PWR: U100.83 (PK6); also elsewhere on the board
VSYS_ENABLE: U100.60 (PC7); also elsewhere on the board

Notes on the sheet:
main control unit
connectors
I²C MUX
processor
JTAG
UART
ISP
RTC
CR2032
EEPROM
do not place
