Geowissenschaften/EXCISS/PCB/EXCISS Mainboard.brd

## EAGLE design PCB/EXCISS Mainboard.brd (continued)

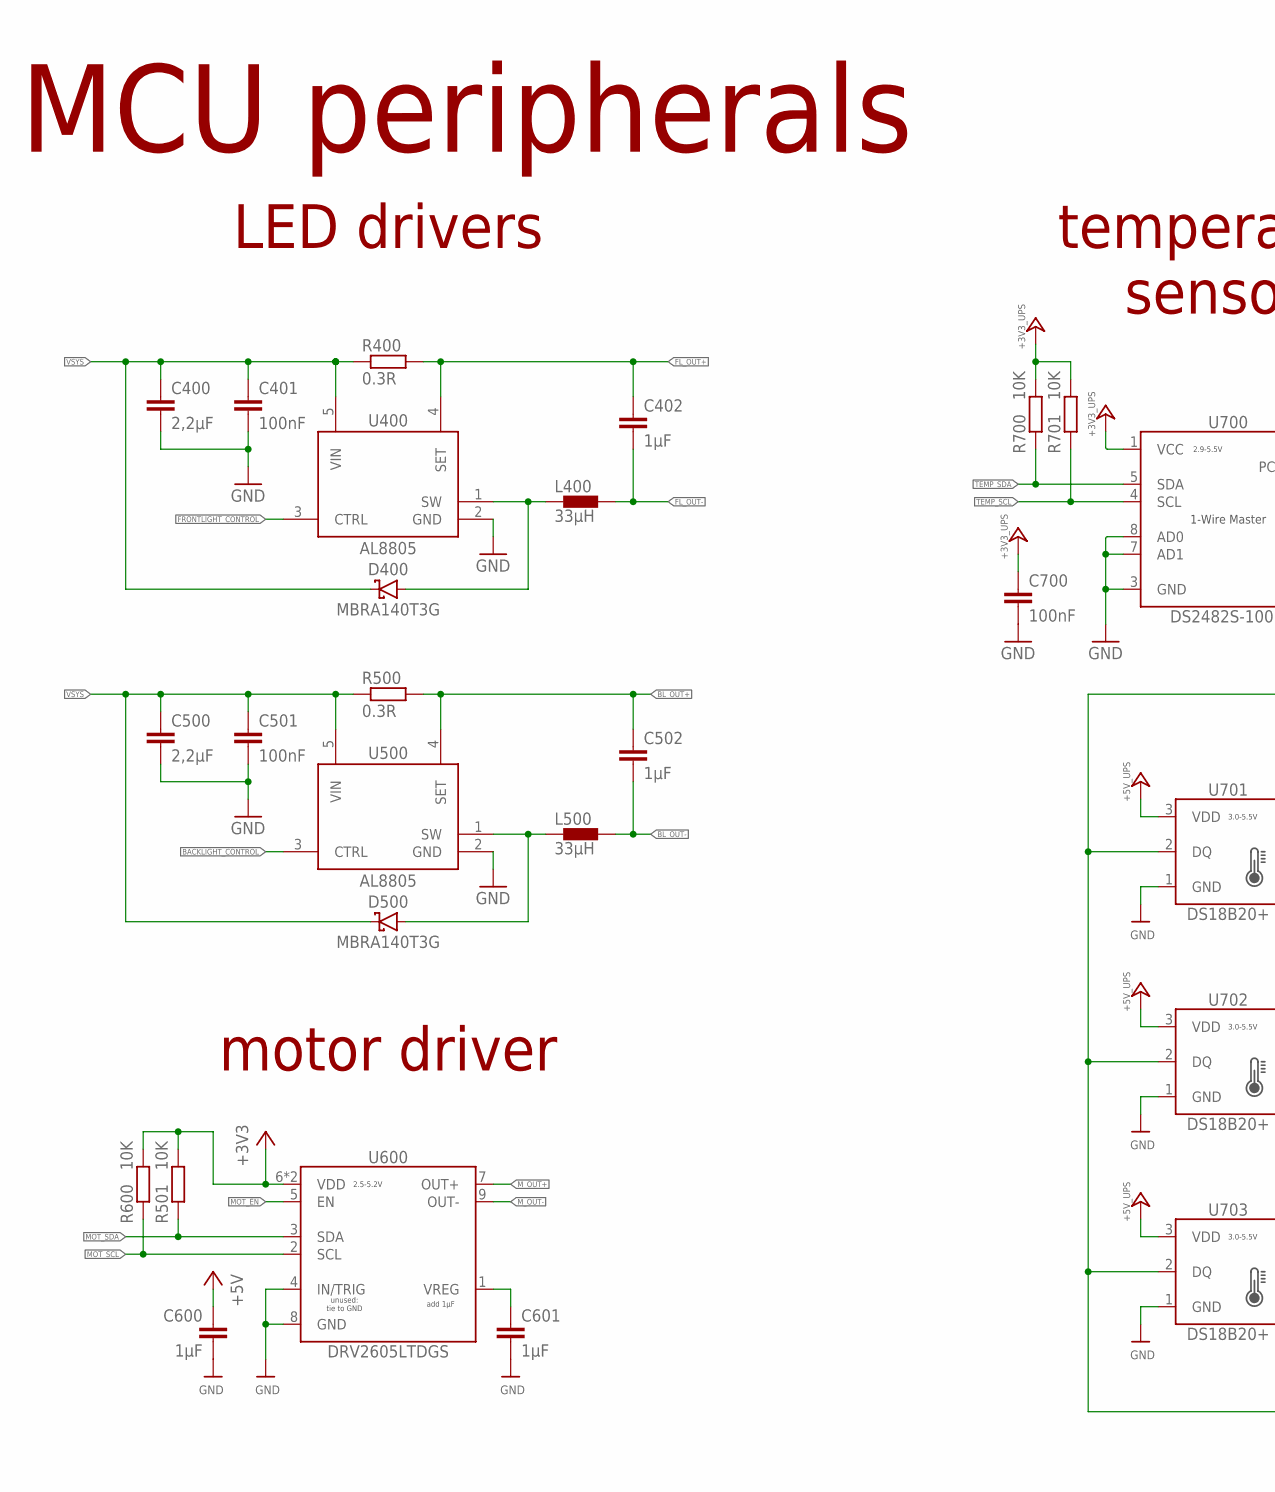
[picture p22: schematic EXCISS Mainboard.sch, sheet 2, part in row 1, column 1]

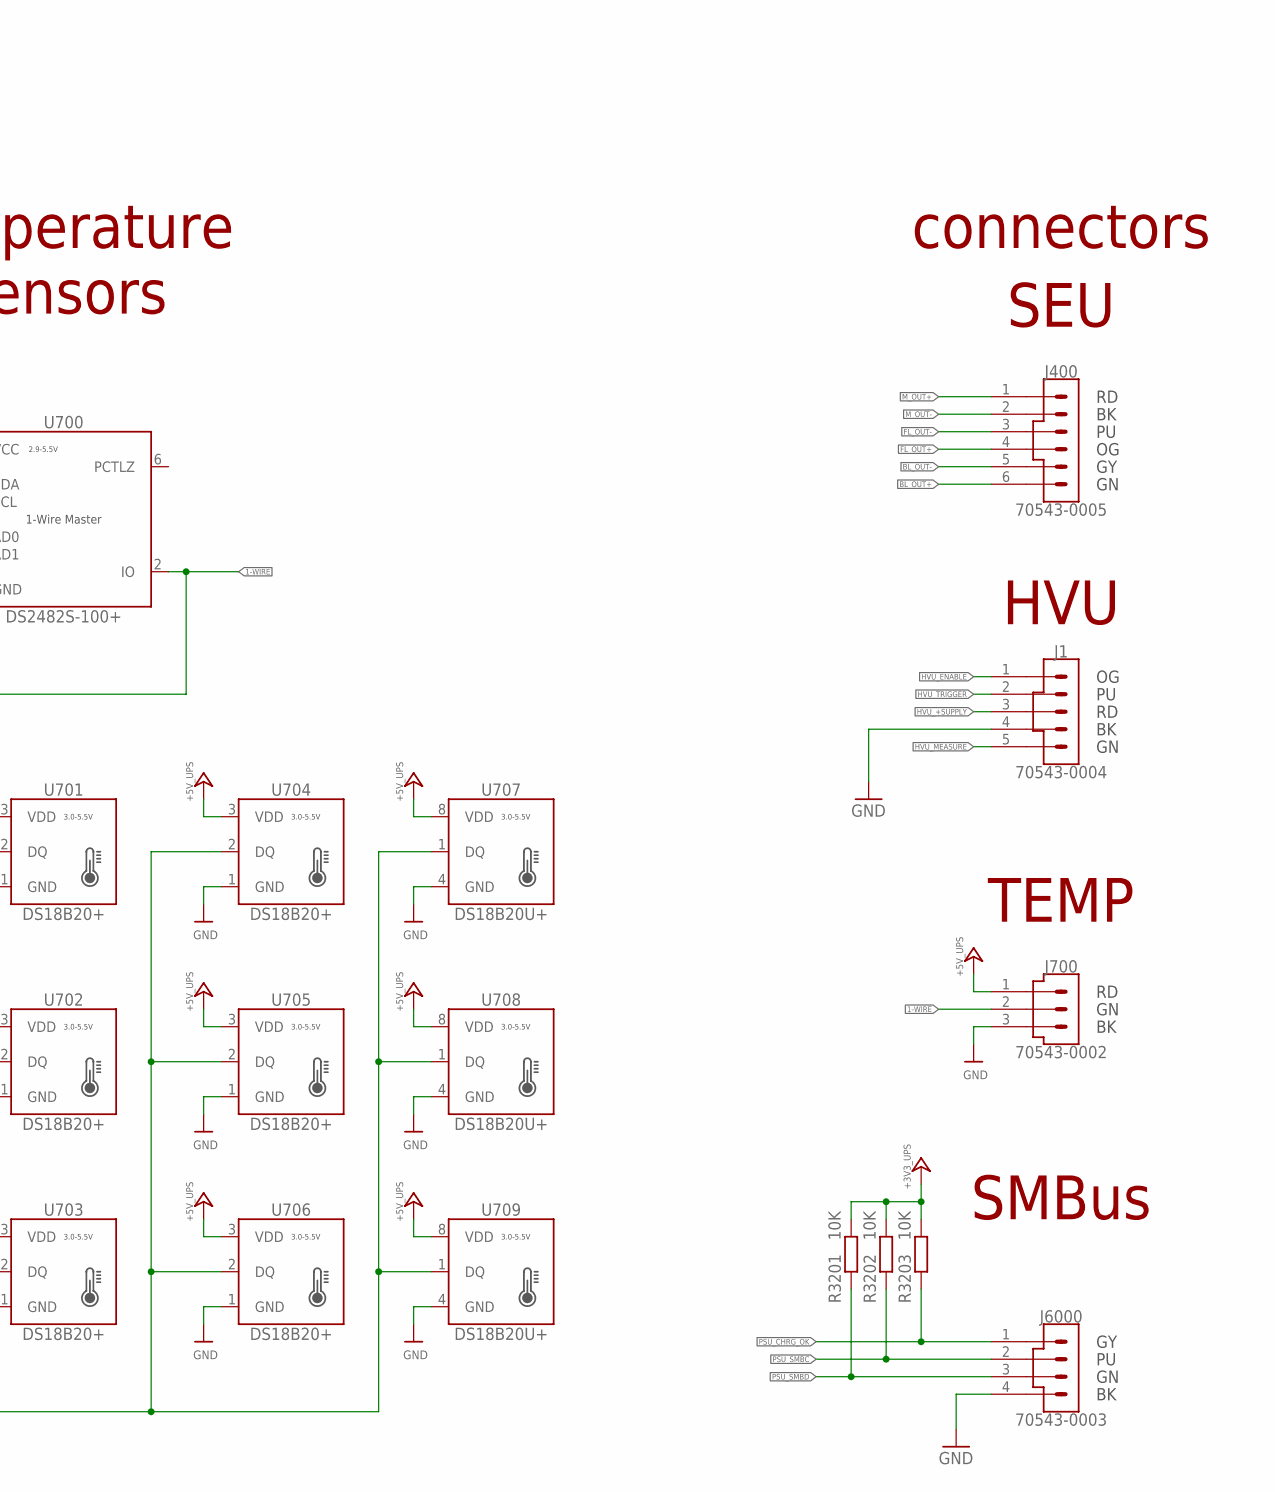
[picture p23: schematic EXCISS Mainboard.sch, sheet 2, part in row 1, column 2]

Parts:
C400, C500: 2,2µF; C1206
C401, C501: 100nF; C0805
C402, C502, C600, C601: 1µF; C0805
C700: 100nF; C0603
D400, D500: MBRA140T3G; 403D-02
J1: 70543-0004; MOLEX_70543-0004
J400: 70543-0005; MOLEX_70543-0005
J700: 70543-0002; MOLEX_70543-0002
J6000: 70543-0003; MOLEX_70543-0003
L400, L500: 33µH; SRN6045
R400, R500: 0.3R; R0805
R501, R600, R700, R701, R3201, R3202, R3203: 10K; R0603
U400, U500: AL8805; DBV(R-PDSO-G5)
U600: DRV2605LTDGS; PSOP10
U700: DS2482S-100+; SOIC8
U701, U702, U703, U704, U705, U706: DS18B20+; TO-92-STRAIGHT
U707, U708, U709: DS18B20U+; µSOP

Connections:
1-WIRE: J700.2, U700.2 (IO), U701.2 (DQ), U702.2 (DQ), U703.2 (DQ), U704.2 (DQ), U705.2 (DQ), U706.2 (DQ), U707.1 (DQ), U708.1 (DQ), U709.1 (DQ)
+3V3: C600.1, R501.1, R600.1, U600.6 (VDD), U600.10 (VDD); also elsewhere on the board
+3V3_UPS: C700.1, R700.1, R701.1, R3201.1, R3202.1, R3203.1, U700.1 (VCC); also elsewhere on the board
+5V_UPS: J700.1, U701.3 (VDD), U702.3 (VDD), U703.3 (VDD), U704.3 (VDD), U705.3 (VDD), U706.3 (VDD), U707.8 (VDD), U708.8 (VDD), U709.8 (VDD); also elsewhere on the board
BACKLIGHT_CONTROL: U500.3 (CTRL); also elsewhere on the board
BL_OUT+: C502.1, J400.6, R500.2, U500.4 (SET)
BL_OUT-: C502.2, J400.5, L500.2
BL_SW: D500.A, L500.1, U500.1 (SW)
FL_OUT+: C402.1, J400.4, R400.2, U400.4 (SET)
FL_OUT-: C402.2, J400.3, L400.2
FL_SW: D400.A, L400.1, U400.1 (SW)
FRONTLIGHT_CONTROL: U400.3 (CTRL); also elsewhere on the board
GND: C400.2, C401.2, C500.2, C501.2, C600.2, C601.2, C700.2, J1.4, J700.3, J6000.4, U400.2 (GND), U500.2 (GND), U600.4 (IN/TRIG), U600.8 (GND), U700.3 (GND), U700.7 (AD1), U700.8 (AD0), U701.1 (GND), U702.1 (GND), U703.1 (GND), U704.1 (GND), U705.1 (GND), U706.1 (GND), U707.4 (GND), U708.4 (GND), U709.4 (GND); also elsewhere on the board
HVU_+SUPPLY: J1.3; also elsewhere on the board
HVU_ENABLE: J1.1; also elsewhere on the board
HVU_MEASURE: J1.5; also elsewhere on the board
HVU_TRIGGER: J1.2; also elsewhere on the board
MOT_!EN: U600.5 (EN); also elsewhere on the board
MOT_SCL: R600.2, U600.2 (SCL); also elsewhere on the board
MOT_SDA: R501.2, U600.3 (SDA); also elsewhere on the board
M_OUT+: J400.1, U600.7 (OUT+)
M_OUT-: J400.2, U600.9 (OUT-)
unnamed: C601.1, U600.1 (VREG)
PSU_CHRG_OK: J6000.1, R3203.2; also elsewhere on the board
PSU_SMBC: J6000.2, R3202.2; also elsewhere on the board
PSU_SMBD: J6000.3, R3201.2; also elsewhere on the board
TEMP_SCL: R701.2, U700.4 (SCL); also elsewhere on the board
TEMP_SDA: R700.2, U700.5 (SDA); also elsewhere on the board
VSYS: C400.1, C401.1, C500.1, C501.1, D400.C, D500.C, R400.1, R500.1, U400.5 (VIN), U500.5 (VIN); also elsewhere on the board

Notes on the sheet:
MCU peripherals
LED drivers
motor driver
temperature sensors
connectors
SEU
TEMP
HVU
SMBus

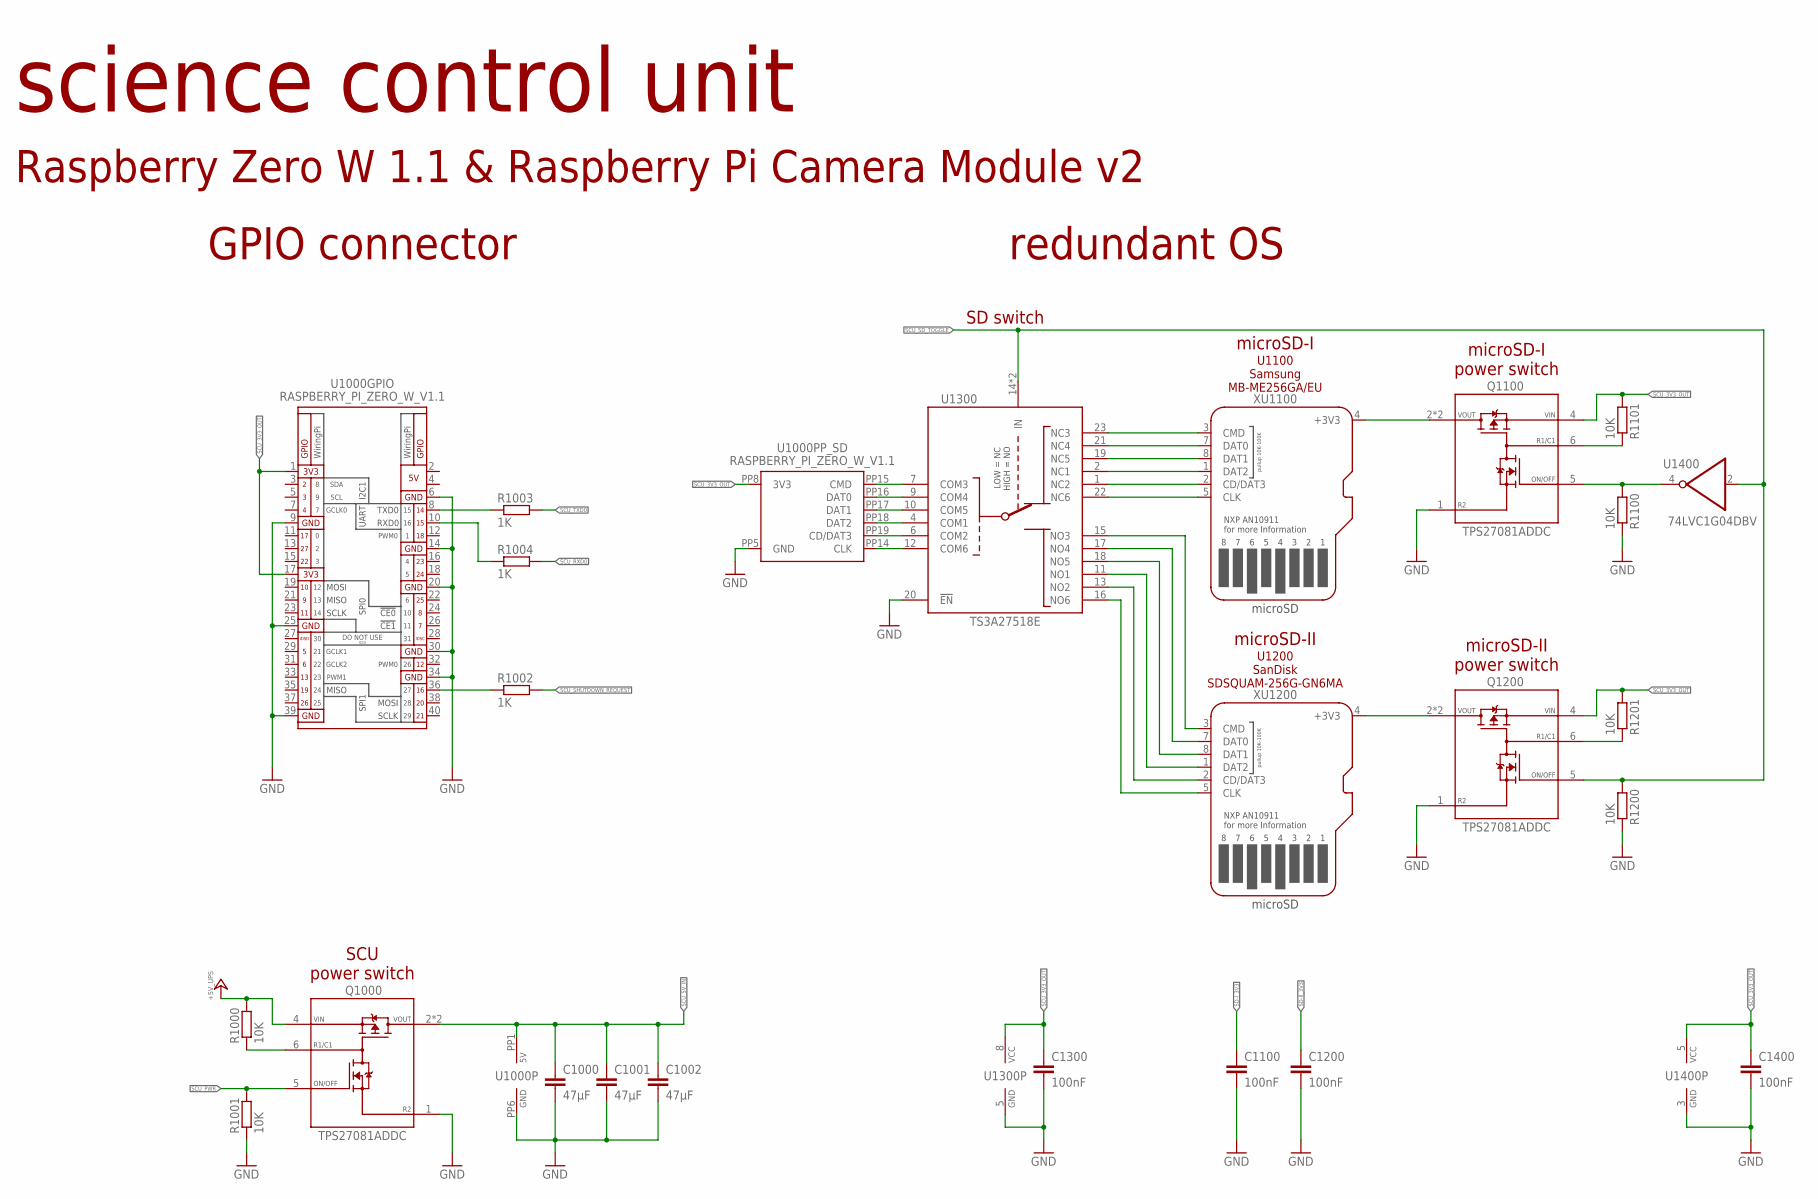
[picture p24: schematic EXCISS Mainboard.sch, sheet 3]

Parts:
C1000, C1001, C1002: 47µF; C1210
C1100, C1200, C1300, C1400: 100nF; C0603
Q1000, Q1100, Q1200: TPS27081ADDC; DDC(R-PDSO-G6)
R1000, R1001, R1100, R1101, R1200, R1201: 10K; R0603
R1002, R1003, R1004: 1K; R0603
U1000: RASPBERRY_PI_ZERO_W_V1.1
U1300: TS3A27518E; TSSOP24
U1400: 74LVC1G04DBV; DBV(R-PDSO-G5)
XU1100, XU1200: MICROSDMOLEX_104031; MICROSD_MOLEX_104031

Connections:
+5V_UPS: Q1000.4 (VIN), R1000.2; also elsewhere on the board
GND: C1000.2, C1001.2, C1002.2, C1100.2, C1200.2, C1300.2, C1400.2, Q1000.1 (R2), Q1100.1 (R2), Q1200.1 (R2), R1001.1, R1100.1, R1200.1, U1000.6 (GND), U1000.9 (GND), U1000.14 (GND), U1000.20 (GND), U1000.25 (GND), U1000.30 (GND), U1000.34 (GND), U1000.39 (GND), U1000.PP5 (GND), U1000.PP6 (GND), U1300.5 (GND), U1300.20 (!EN), U1400.3 (GND), XU1100.6 (GND), XU1100.G1 (GND), XU1100.G2 (GND), XU1100.G3 (GND), XU1100.G4 (GND), XU1200.6 (GND), XU1200.G1 (GND), XU1200.G2 (GND), XU1200.G3 (GND), XU1200.G4 (GND); also elsewhere on the board
unnamed: U1000.PP15 (CMD), U1300.7 (COM3)
unnamed: U1000.PP16 (DAT0), U1300.9 (COM4)
unnamed: U1000.PP14 (CLK), U1300.12 (COM6)
unnamed: U1000.PP19 (CD/DAT3), U1300.6 (COM2)
unnamed: U1000.PP18 (DAT2), U1300.4 (COM1)
unnamed: U1000.PP17 (DAT1), U1300.10 (COM5)
unnamed: R1002.1, U1000.36 (GPIO16)
unnamed: R1004.1, U1000.10 (GPIO15/RXD0)
unnamed: R1003.1, U1000.8 (GPIO14/TXD0)
R1/C1: Q1100.6 (R1/C1), R1101.1
R1/C2: Q1200.6 (R1/C1), R1201.1
R1/C6: Q1000.6 (R1/C1), R1000.1
SCU_3V3_OUT: C1300.1, C1400.1, Q1100.4 (VIN), Q1200.4 (VIN), R1101.2, R1201.2, U1000.1 (3V3), U1000.17 (3V3), U1000.PP8 (3V3), U1300.8 (VCC), U1400.5 (VCC)
SCU_5V_IN: C1000.1, C1001.1, C1002.1, Q1000.2 (VOUT), Q1000.3 (VOUT), U1000.PP1 (5V)
SCU_PWR: Q1000.5 (ON/OFF), R1001.2; also elsewhere on the board
SCU_RXD0: R1004.2; also elsewhere on the board
SCU_SD_!TOGGLE: Q1100.5 (ON/OFF), R1100.2, U1400.4 (O)
SCU_SD_TOGGLE: Q1200.5 (ON/OFF), R1200.2, U1300.14 (IN), U1300.24 (IN), U1400.2 (I); also elsewhere on the board
SCU_SHUTDOWN_REQUEST: R1002.2; also elsewhere on the board
SCU_TXD0: R1003.2; also elsewhere on the board
SD-1_CD/DAT3: U1300.1 (NC2), XU1100.2 (CD/DAT3)
SD-1_CLK: U1300.22 (NC6), XU1100.5 (CLK)
SD-1_CMD: U1300.23 (NC3), XU1100.3 (CMD)
SD-1_DAT0: U1300.21 (NC4), XU1100.7 (DAT0)
SD-1_DAT1: U1300.19 (NC5), XU1100.8 (DAT1)
SD-1_DAT2: U1300.2 (NC1), XU1100.1 (DAT2)
SD-2_CD/DAT3: U1300.13 (NO2), XU1200.2 (CD/DAT3)
SD-2_CLK: U1300.16 (NO6), XU1200.5 (CLK)
SD-2_CMD: U1300.15 (NO3), XU1200.3 (CMD)
SD-2_DAT0: U1300.17 (NO4), XU1200.7 (DAT0)
SD-2_DAT1: U1300.18 (NO5), XU1200.8 (DAT1)
SD-2_DAT2: U1300.11 (NO1), XU1200.1 (DAT2)
SD-II_3V3: C1200.1, Q1200.2 (VOUT), Q1200.3 (VOUT), XU1200.4 (+3V3)
SD-I_3V3: C1100.1, Q1100.2 (VOUT), Q1100.3 (VOUT), XU1100.4 (+3V3)

Notes on the sheet:
science control unit
GPIO connector
redundant OS
microSD-I power switch
microSD-II power switch
SCU power switch
Raspberry Zero W 1.1 & Raspberry Pi Camera Module v2
microSD-I
microSD-II
SD switch
U1100 Samsung MB-ME256GA/EU
U1200 SanDisk SDSQUAM-256G-GN6MA

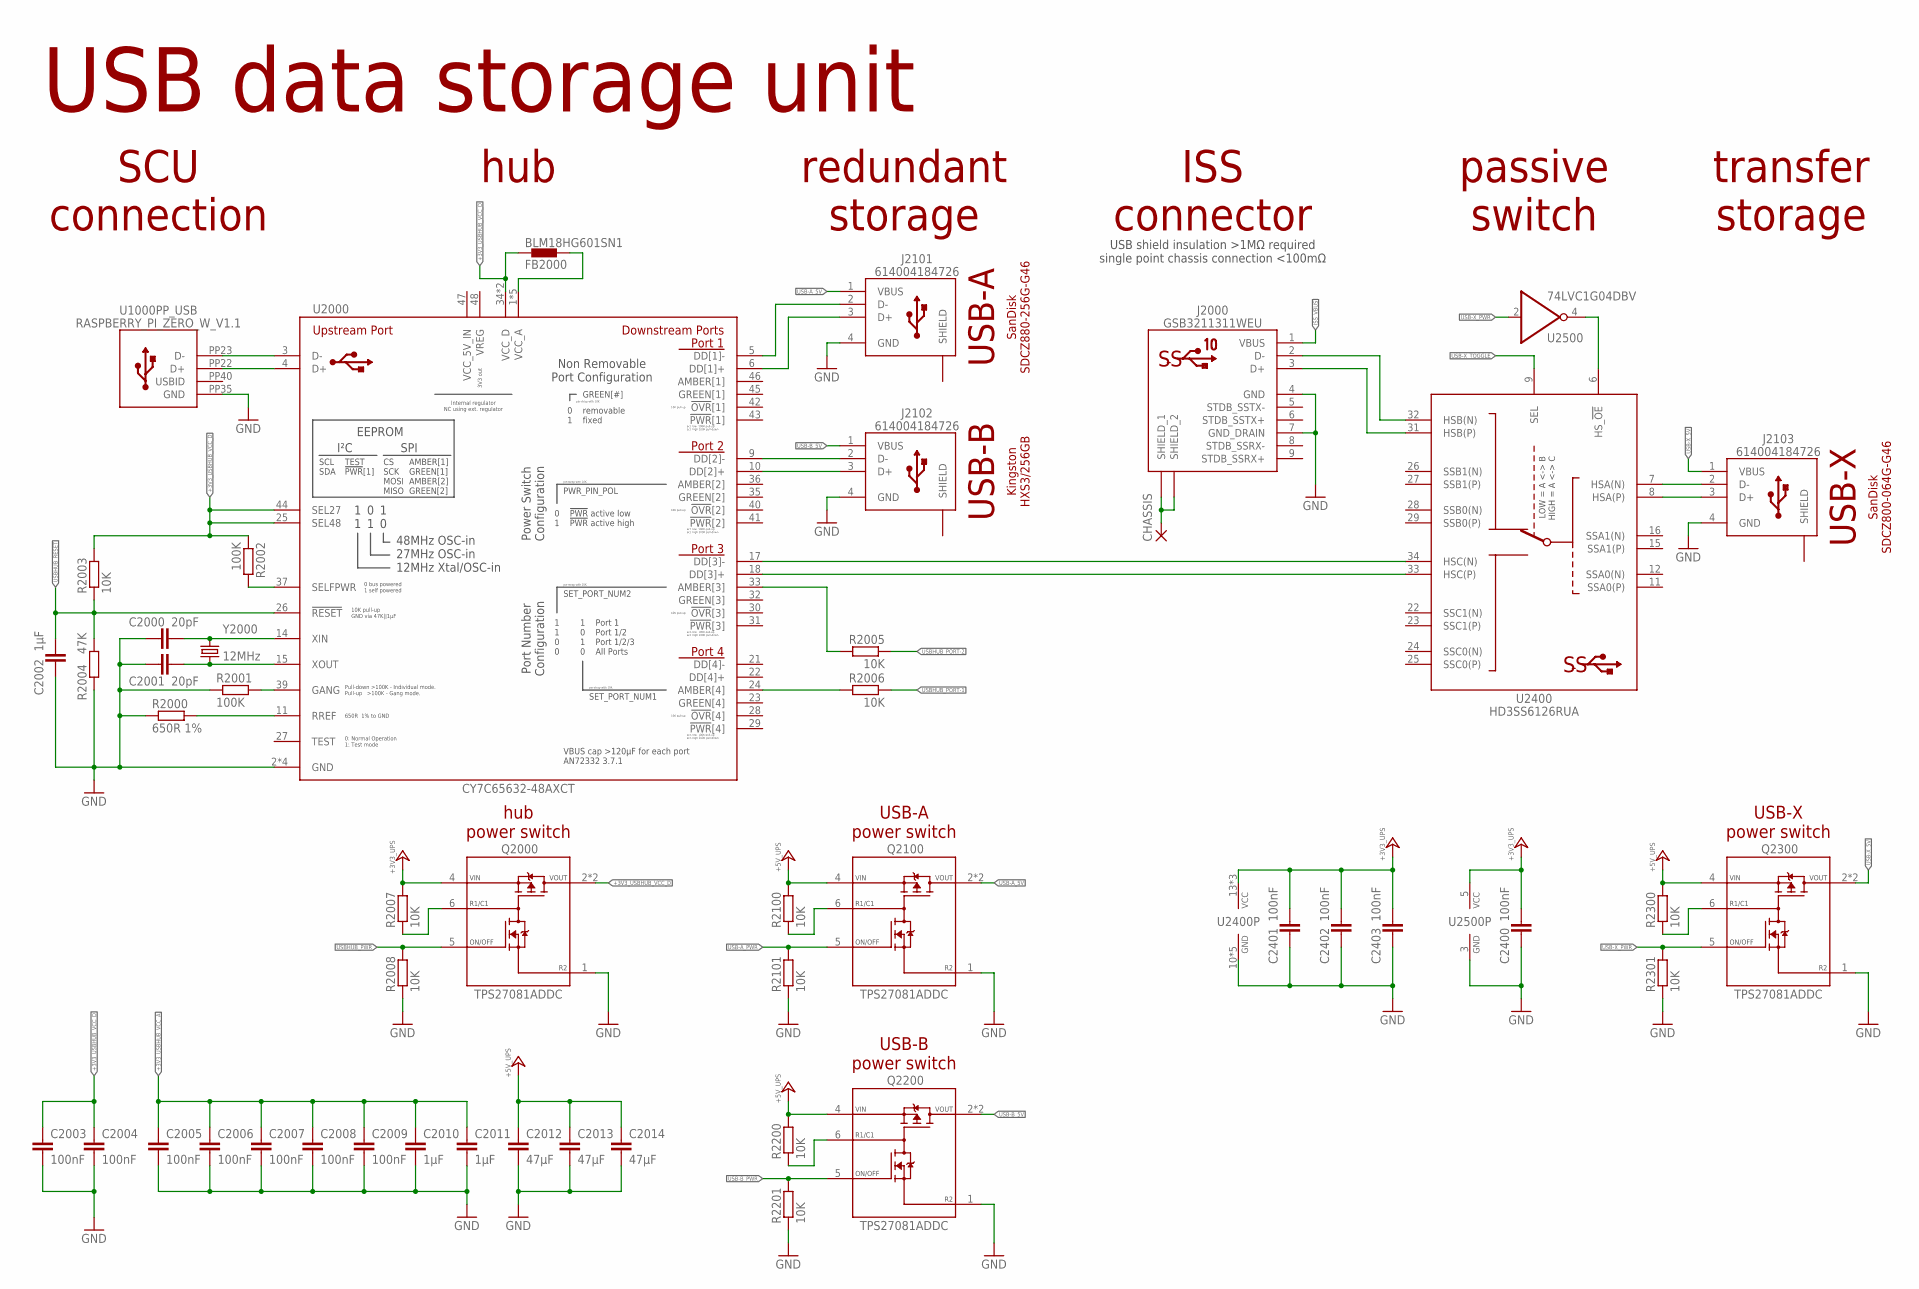
[picture p25: schematic EXCISS Mainboard.sch, sheet 4]

Parts:
C2000, C2001: 20pF; C0603
C2002, C2010, C2011: 1µF; C0805
C2003, C2004, C2005, C2006, C2007, C2008, C2009, C2400, C2401, C2402, C2403: 100nF; C0603
C2012, C2013, C2014: 47µF; C1210
CHASSIS: PAD_M2.5
FB2000: BLM18HG601SN1; 0603
J2000: GSB3211311WEU
J2101, J2102, J2103: 614004184726
Q2000, Q2100, Q2200, Q2300: TPS27081ADDC; DDC(R-PDSO-G6)
R2000: 650R 1%; R0603
R2001, R2002: 100K; R0603
R2003, R2005, R2006, R2007, R2008, R2100, R2101, R2200, R2201, R2300, R2301: 10K; R0603
R2004: 47K; R0603
U1000: RASPBERRY_PI_ZERO_W_V1.1
U2000: CY7C65632-48AXCT; TQFP48
U2400: HD3SS6126RUA; RUA(R-PWQFN-N42)
U2500: 74LVC1G04DBV; DBV(R-PDSO-G5)
Y2000: 12MHz; HC49UP

Connections:
+3V3_UPS: C2400.1, C2401.1, C2402.1, C2403.1, Q2000.4 (VIN), R2007.2, U2400.13 (VCC), U2400.20 (VCC), U2400.30 (VCC), U2500.5 (VCC); also elsewhere on the board
+3V3_USBHUB_VCC_A: C2005.1, C2006.1, C2007.1, C2008.1, C2009.1, C2010.1, C2011.1, FB2000.2, U2000.1 (VCC_A), U2000.7 (VCC_A), U2000.12 (VCC_A), U2000.16 (VCC_A), U2000.19 (VCC_A)
+3V3_USBHUB_VCC_D: C2003.1, C2004.1, FB2000.1, Q2000.2 (VOUT), Q2000.3 (VOUT), R2002.1, R2003.2, U2000.25 (SEL48), U2000.34 (VCC_D), U2000.38 (VCC_D), U2000.44 (SEL27)
+5V_UPS: C2012.1, C2013.1, C2014.1, Q2100.4 (VIN), Q2200.4 (VIN), Q2300.4 (VIN), R2100.2, R2200.2, R2300.2; also elsewhere on the board
DD[1]_N: J2101.2 (D-), U2000.5 (DD[1]-)
DD[1]_P: J2101.3 (D+), U2000.6 (DD[1]+)
DD[2]_N: J2102.2 (D-), U2000.9 (DD[2]-)
DD[2]_P: J2102.3 (D+), U2000.10 (DD[2]+)
DD[3]_N: U2000.17 (DD[3]-), U2400.34 (HSC(N))
DD[3]_P: U2000.18 (DD[3]+), U2400.33 (HSC(P))
DU_N: U1000.PP23 (D-), U2000.3 (D-)
DU_P: U1000.PP22 (D+), U2000.4 (D+)
GND: C2000.2, C2001.2, C2002.2, C2003.2, C2004.2, C2005.2, C2006.2, C2007.2, C2008.2, C2009.2, C2010.2, C2011.2, C2012.2, C2013.2, C2014.2, C2400.2, C2401.2, C2402.2, C2403.2, J2000.4 (GND), J2000.7 (GND_DRAIN), J2101.4 (GND), J2102.4 (GND), J2103.4 (GND), Q2000.1 (R2), Q2100.1 (R2), Q2200.1 (R2), Q2300.1 (R2), R2000.1, R2001.1, R2004.1, R2008.1, R2101.1, R2201.1, R2301.1, U1000.PP35 (GND), U2000.2 (GND), U2000.8 (GND), U2000.13 (GND), U2000.20 (GND), U2400.10 (GND), U2400.14 (GND), U2400.17 (GND), U2400.19 (GND), U2400.21 (GND), U2400.TP0 (GND), U2400.TP1 (GND), U2400.TP2 (GND), U2400.TP3 (GND), U2400.TP4 (GND), U2400.TP5 (GND), U2400.TP6 (GND), U2400.TP7 (GND), U2400.TP8 (GND), U2400.TP9 (GND), U2400.TP10 (GND), U2400.TP11 (GND), U2400.TP12 (GND), U2400.TP13 (GND), U2400.TP14 (GND), U2500.3 (GND); also elsewhere on the board
ISS_VBUS: J2000.1 (VBUS); also elsewhere on the board
unnamed: CHASSIS.P$1, J2000.SHIELD_1, J2000.SHIELD_2
unnamed: Q2100.6 (R1/C1), R2100.1
unnamed: R2001.2, U2000.39 (GANG)
unnamed: C2000.1, U2000.14 (XIN), Y2000.1
unnamed: C2001.1, U2000.15 (XOUT), Y2000.2
unnamed: R2006.2, U2000.24 (AMBER[4])
unnamed: R2005.2, U2000.33 (AMBER[3])
unnamed: R2000.2, U2000.11 (RREF)
unnamed: R2002.2, U2000.37 (SELFPWR)
R1/C3: Q2000.6 (R1/C1), R2007.1
R1/C4: Q2200.6 (R1/C1), R2200.1
R1/C5: Q2300.6 (R1/C1), R2300.1
USB-A_5V: J2101.1 (VBUS), Q2100.2 (VOUT), Q2100.3 (VOUT)
USB-A_PWR: Q2100.5 (ON/OFF), R2101.2; also elsewhere on the board
USB-B_5V: J2102.1 (VBUS), Q2200.2 (VOUT), Q2200.3 (VOUT)
USB-B_PWR: Q2200.5 (ON/OFF), R2201.2; also elsewhere on the board
USB-X_5V: J2103.1 (VBUS), Q2300.2 (VOUT), Q2300.3 (VOUT)
USB-X_!PWR: U2400.6 (HS_!OE), U2500.4 (O)
USB-X_PWR: Q2300.5 (ON/OFF), R2301.2, U2500.2 (I); also elsewhere on the board
USB-X_TOGGLE: U2400.9 (SEL); also elsewhere on the board
USBHUB_!RESET: C2002.1, R2003.1, R2004.2, U2000.26 (!RESET); also elsewhere on the board
USBHUB_PORT-1: R2006.1; also elsewhere on the board
USBHUB_PORT-2: R2005.1; also elsewhere on the board
USBHUB_PWR: Q2000.5 (ON/OFF), R2008.2; also elsewhere on the board
USBISS_D_N: J2000.2 (D-), U2400.32 (HSB(N))
USBISS_D_P: J2000.3 (D+), U2400.31 (HSB(P))
USBX_D_N: J2103.2 (D-), U2400.7 (HSA(N))
USBX_D_P: J2103.3 (D+), U2400.8 (HSA(P))
VCC_5V_IN: U2000.47 (VCC_5V_IN)

Notes on the sheet:
USB data storage unit
hub
passive switch
USB-X
USB-A
USB-B
ISS connector
redundant storage
SCU connection
transfer storage
USB shield insulation >1MΩ required single point chassis connection <100mΩ
SanDisk SDCZ880-256G-G46
Kingston HXS3/256GB
SanDisk SDCZ800-064G-G46
USB-A power switch
USB-B power switch
hub power switch
USB-X power switch

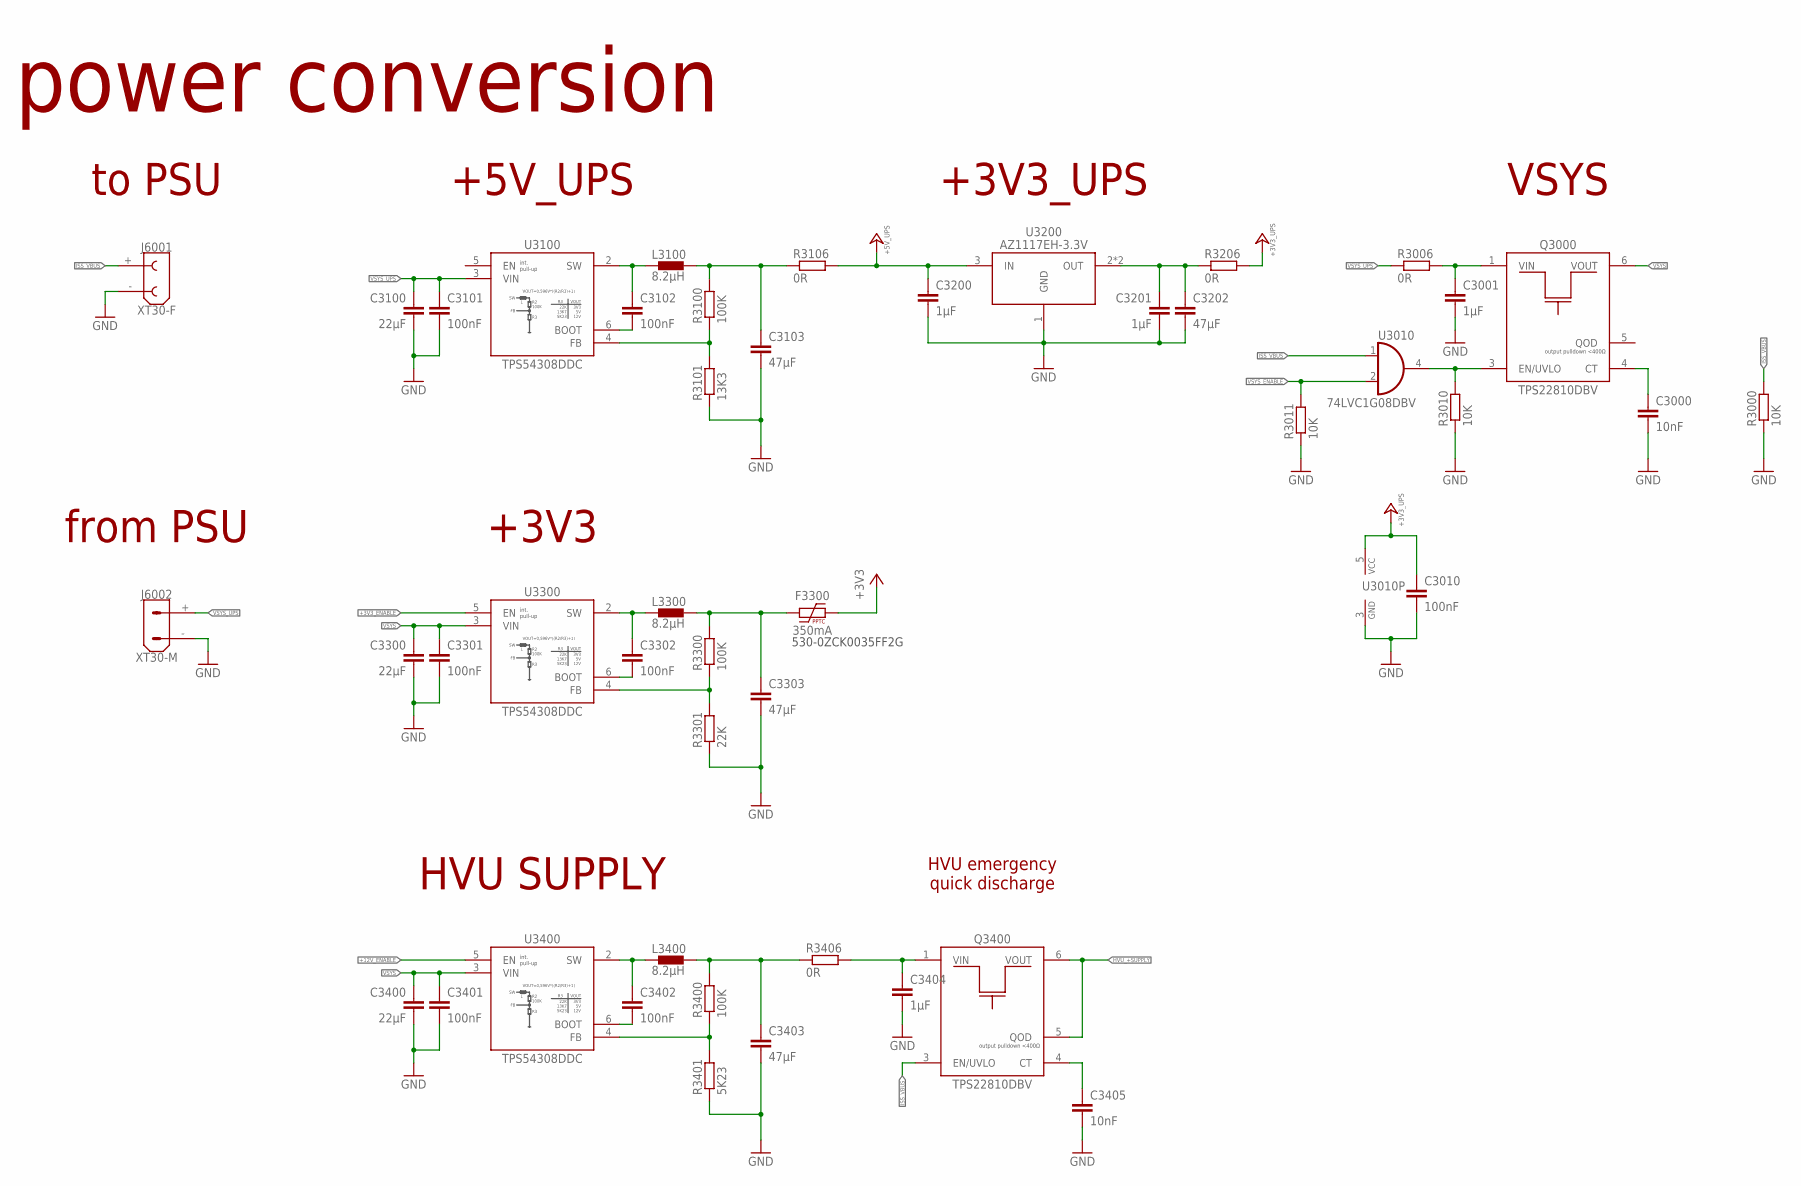
[picture p26: schematic EXCISS Mainboard.sch, sheet 5]

Parts:
C3000, C3405: 10nF; C0603
C3001, C3200, C3201, C3404: 1µF; C0805
C3010, C3101, C3102, C3301, C3302, C3401, C3402: 100nF; C0805
C3100, C3300, C3400: 22µF; C1206
C3103, C3202, C3303, C3403: 47µF; C1210
F3300: 350mA; R0805_NOCREAM
J6001: XT30-F
J6002: XT30-M
L3100, L3300, L3400: 8.2µH; SRP6540
Q3000, Q3400: TPS22810DBV; SOT23-6_DBV
R3000: 10K; R1206
R3006, R3106, R3206, R3406: 0R; R0805_NOCREAM
R3010, R3011: 10K; R0603
R3100, R3300, R3400: 100K; R0603
R3101: 13K3; R0603
R3301: 22K; R0603
R3401: 5K23; R0603
U3010: 74LVC1G08DBV; SOT23-5
U3100, U3300, U3400: TPS54308DDC; DDC(R-PDSO-G6)
U3200: AZ1117EH-3.3V; SOT223

Connections:
+3V3: F3300.2; also elsewhere on the board
+3V3_ENABLE: U3300.5 (EN); also elsewhere on the board
+3V3_UPS: C3010.1, R3206.2, U3010.5 (VCC); also elsewhere on the board
+5V_UPS: C3200.1, R3106.2, U3200.3 (IN); also elsewhere on the board
+12V_ENABLE: U3400.5 (EN); also elsewhere on the board
+12V_STEPDOWN: C3403.1, L3400.2, R3400.2, R3406.1
BST_+5V: C3302.2, U3300.6 (BOOT)
BST_+5V_UPS: C3102.2, U3100.6 (BOOT)
BST_+12V: C3402.2, U3400.6 (BOOT)
GND: C3000.2, C3001.2, C3010.2, C3100.2, C3101.2, C3103.2, C3200.2, C3201.2, C3202.2, C3300.2, C3301.2, C3303.2, C3400.2, C3401.2, C3403.2, C3404.2, C3405.2, J6001.-, J6002.-, Q3000.2 (GND), Q3400.2 (GND), R3000.1, R3010.1, R3011.1, R3101.1, R3301.1, R3401.1, U3010.3 (GND), U3100.1 (GND), U3200.1 (GND), U3300.1 (GND), U3400.1 (GND); also elsewhere on the board
HVU_+SUPPLY: Q3400.5 (QOD), Q3400.6 (VOUT); also elsewhere on the board
ISS_VBUS: J6001.+, Q3400.3 (EN/UVLO), R3000.2, U3010.1 (I0); also elsewhere on the board
unnamed: C3405.1, Q3400.4 (CT)
unnamed: C3000.1, Q3000.4 (CT)
unnamed: C3103.1, L3100.2, R3100.2, R3106.1
unnamed: C3303.1, F3300.1, L3300.2, R3300.2
unnamed: C3404.1, Q3400.1 (VIN), R3406.2
unnamed: C3001.1, Q3000.1 (VIN), R3006.2
unnamed: Q3000.3 (EN/UVLO), R3010.2, U3010.4 (O)
OUT: C3201.1, C3202.1, R3206.1, U3200.2 (OUT), U3200.4 (OUT)
SW_+5V: C3302.1, L3300.1, U3300.2 (SW)
SW_+5V_UPS: C3102.1, L3100.1, U3100.2 (SW)
SW_+12V: C3402.1, L3400.1, U3400.2 (SW)
VFB_+5V: R3300.1, R3301.2, U3300.4 (FB)
VFB_+5V_UPS: R3100.1, R3101.2, U3100.4 (FB)
VFB_+12V: R3400.1, R3401.2, U3400.4 (FB)
VSYS: C3300.1, C3301.1, C3400.1, C3401.1, Q3000.6 (VOUT), U3300.3 (VIN), U3400.3 (VIN); also elsewhere on the board
VSYS_ENABLE: R3011.2, U3010.2 (I1); also elsewhere on the board
VSYS_UPS: C3100.1, C3101.1, J6002.+, R3006.1, U3100.3 (VIN)

Notes on the sheet:
power conversion
VSYS
+5V_UPS
+3V3_UPS
+3V3
HVU SUPPLY
HVU emergency quick discharge
to PSU
from PSU
530-0ZCK0035FF2G

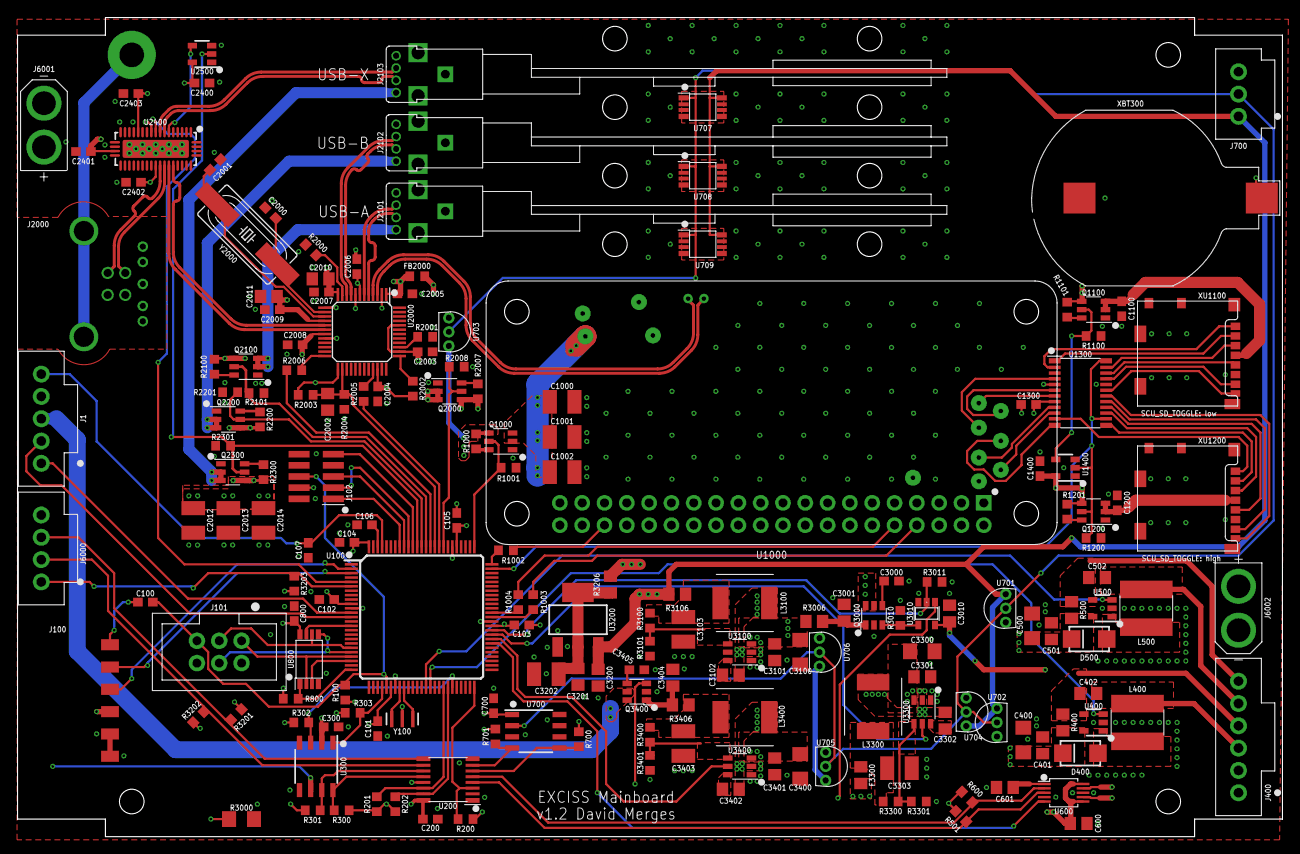
[picture p27: board EXCISS Mainboard.brd from above]

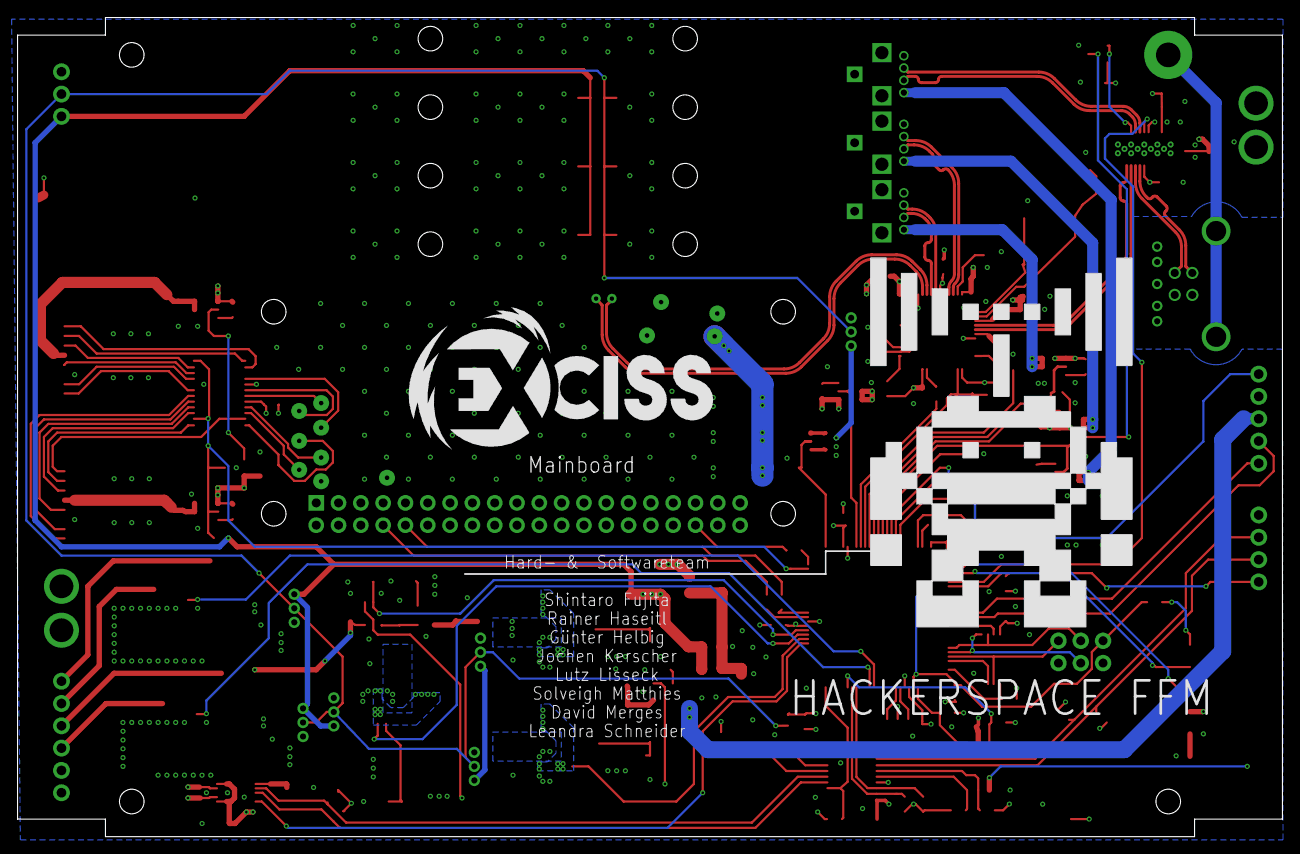
[picture p28: board EXCISS Mainboard.brd from below]

Board: 4 copper layers, 144.0 x 93.2 mm, 194 parts (2 on the bottom side), 149 nets.

Other parts of the board:
U$1: KINGSTON_USB_TRIPLE
U$3: NANOLAB_1.5U
U$4: NANOLAB_1.5U_LIDS
U$15: LOGO_EXCISS
U$16, U$17, U$18: DRILL_M2.5
U$19: LOGO_HACKFFM
