Geowissenschaften/EXCISS/PCB/EXCISS HVU trigger.brd

## EAGLE design PCB/EXCISS HVU trigger.brd (2019-06-11)

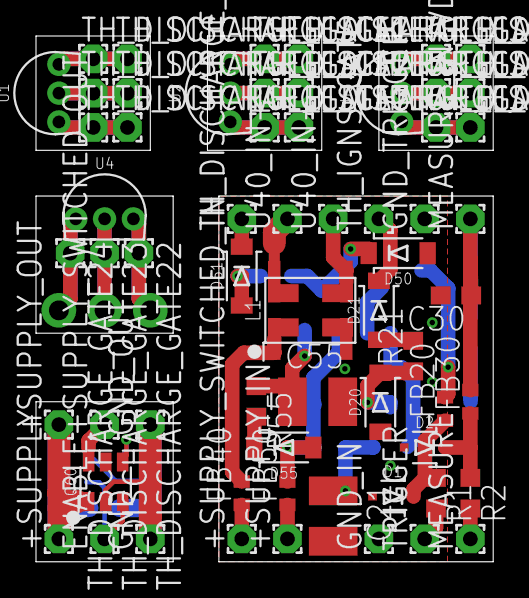
[picture p29: board EXCISS HVU trigger.brd from above]

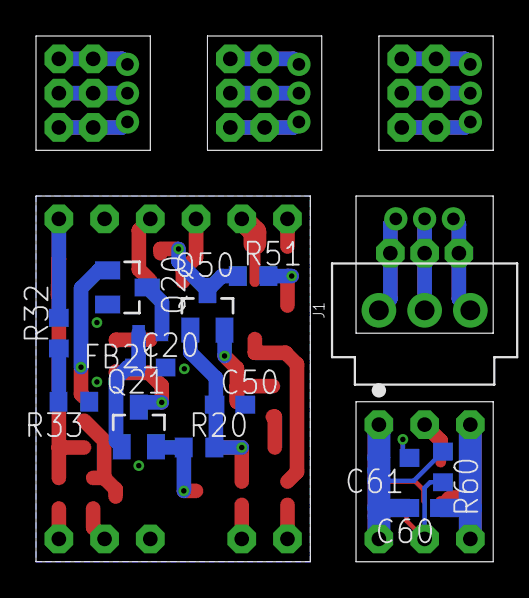
[picture p30: board EXCISS HVU trigger.brd from below]

Board: 2 copper layers, 25.4 x 29.2 mm, 76 parts (14 on the bottom side), 42 nets.

Parts:
+SUPPLY: WIREPAD1,6/0,8; 1,6/0,8
+SUPPLY_IN: WIREPAD1,6/0,8; 1,6/0,8
+SUPPLY_OUT: WIREPAD1,6/0,8; 1,6/0,8
+SUPPLY_SWITCHED_IN: WIREPAD1,6/0,8; 1,6/0,8
+SUPPLY_SWITCHED_OUT: WIREPAD1,6/0,8; 1,6/0,8
C20, C30, C50: 2,2nF; C0603
C21, C55: 47µF; C1210
C60: 1µF; C0603
C61: 10nF; C0603
D1, D2: SP4020-01FTG; SOD-323
D20, D21, D50, D51, D55: SL1M; SOD-123FL
ENABLE: WIREPAD1,6/0,8; 1,6/0,8
FB20, FB21, FB30, FB40, FB50: BLM18PG471SN1D; 0402
GND: WIREPAD1,6/0,8; 1,6/0,8
GND_IN: WIREPAD1,6/0,8; 1,6/0,8
GND_OUT: WIREPAD1,6/0,8; 1,6/0,8
GND_TRIGGER: WIREPAD1,6/0,8; 1,6/0,8
J1: 70543-0002; MOLEX_70543-0002
L1: DLW5ATN272SQ2; DLW5AT
MEASURE: WIREPAD1,6/0,8; 1,6/0,8
MEASURE_IN_VD: WIREPAD1,6/0,8; 1,6/0,8
Q20: PDTC143ZT; SOT23-3
Q21, Q50: PDTB123TT; SOT23-3
Q60: TPS22810DBV; SOT23-6_DBV
R1, R2: 100R; R0603
R20, R55: 4,7K; R0603
R21, R51: 180R; R0603
R32: 22K; R0603
R33: 3,9K; R0603
R60: 10K; R0603
TH_DISCHARGE_GATE, TH_DISCHARGE_GATE1, TH_DISCHARGE_GATE2, TH_DISCHARGE_GATE3, TH_DISCHARGE_GATE4, TH_DISCHARGE_GATE5, TH_DISCHARGE_GATE6, TH_DISCHARGE_GATE7, TH_DISCHARGE_GATE8, TH_DISCHARGE_GATE9, TH_DISCHARGE_GATE10, TH_DISCHARGE_GATE11, TH_DISCHARGE_GATE12, TH_DISCHARGE_GATE13, TH_DISCHARGE_GATE14, TH_DISCHARGE_GATE15, TH_DISCHARGE_GATE16, TH_DISCHARGE_GATE17, TH_DISCHARGE_GATE18, TH_DISCHARGE_GATE22, TH_DISCHARGE_GATE23, TH_DISCHARGE_GATE24: WIREPAD1,6/0,8; 1,6/0,8
TH_IGNS_GATE: WIREPAD1,6/0,8; 1,6/0,8
TRIGGER: WIREPAD1,6/0,8; 1,6/0,8
U1, U2, U3, U4: DS18B20+; TO-92-STRAIGHT
U40_IN+, U40_IN-: WIREPAD1,6/0,8; 1,6/0,8

Connections:
+HVU_SUPPLY_SWITCHED_FB: FB40.2, L1.1A, L1.1B+
+SUPPLY: +SUPPLY_IN.1, FB50.1
+SUPPLY$1: +SUPPLY.1, +SUPPLY_OUT.1, C60.1, Q60.1
+SUPPLY_FB: C50.1, D55.A, FB50.2, Q50.1, R20.2
+SUPPLY_SWITCHED: +SUPPLY_SWITCHED_IN.1, FB40.1
+SUPPLY_SWITCHED$1: +SUPPLY_SWITCHED_OUT.1, Q60.6
AGND: C20.2, C21.2, C30.2, C50.2, C55.2, D1.A, D2.A, D20.A, D50.A, GND_IN.1, GND_TRIGGER.1, L1.4A, L1.4B, Q20.2, R33.1
ENABLE: ENABLE.1, Q60.3, R60.2
GND: C60.2, C61.2, GND.1, GND_OUT.1, Q60.2, R60.1
MEASURE: D2.C, FB30.1, R2.1
MEASURE_FB: C30.1, FB30.2, MEASURE_IN_VD.1, R32.2
unnamed: MEASURE.1, R2.2
unnamed: D20.C, Q21.3, R21.1
unnamed: D21.C, TH_IGNS_GATE.1
unnamed: R32.1, R33.2
unnamed: R1.2, TRIGGER.1
unnamed: TH_DISCHARGE_GATE1.1, TH_DISCHARGE_GATE4.1, U1.3
unnamed: C21.1, Q21.2, R20.1
unnamed: TH_DISCHARGE_GATE2.1, TH_DISCHARGE_GATE5.1, U1.2
unnamed: D21.A, R21.2
unnamed: TH_DISCHARGE_GATE3.1, TH_DISCHARGE_GATE6.1, U1.1
unnamed: L1.3A, L1.3B, U40_IN-.1
unnamed: TH_DISCHARGE_GATE7.1, TH_DISCHARGE_GATE10.1, U2.3
unnamed: C20.1, FB21.2, Q21.1
unnamed: C61.1, Q60.4
unnamed: D51.C, TH_DISCHARGE_GATE.1
unnamed: TH_DISCHARGE_GATE8.1, TH_DISCHARGE_GATE11.1, U2.2
unnamed: TH_DISCHARGE_GATE9.1, TH_DISCHARGE_GATE12.1, U2.1
unnamed: FB21.1, Q20.3
unnamed: TH_DISCHARGE_GATE13.1, TH_DISCHARGE_GATE16.1, U3.3
unnamed: D51.A, R51.2
unnamed: L1.2A, L1.2B, U40_IN+.1
unnamed: TH_DISCHARGE_GATE14.1, TH_DISCHARGE_GATE17.1, U3.2
unnamed: D50.C, Q50.3, R51.1
unnamed: C55.1, Q50.2, R55.1
unnamed: D55.C, R55.2
unnamed: TH_DISCHARGE_GATE15.1, TH_DISCHARGE_GATE18.1, U3.1
unnamed: J1.1, TH_DISCHARGE_GATE22.1, U4.3
unnamed: J1.2, TH_DISCHARGE_GATE23.1, U4.2
unnamed: J1.3, TH_DISCHARGE_GATE24.1, U4.1
TRIGGER: D1.C, FB20.1, R1.1
TRIGGER_FB: FB20.2, Q20.1
