Geowissenschaften/EXCISS/Software/MCU/firmware/src/config_VIBRATION_MOTOR.h

/***********************************************************************
* DESCRIPTION :
*
* 
* AUTHOR :    Shintaro Fujita
*
**/


#ifndef _CONFIG_VIBRATION_MOTOR_H_
#define _CONFIG_VIBRATION_MOTOR_H_

// ------------------------------------
// safety timeouts

#define VIBRATION_MOTOR__MAX_RUN_TIMEOUT_SEC		120UL		

#endif
