Geowissenschaften/EXCISS/Software/MCU/firmware/src/config_power.h

/***********************************************************************
* DESCRIPTION :
*
* 
* AUTHOR :    Shintaro Fujita
*
**/


#ifndef _CONFIG_POWER_H_
#define _CONFIG_POWER_H_

// ------------------------------------
// battery power level conditions
// values are percentages

// minimum battery level allowed to start scu in %
#define POWER__MIN_BATTERY_LEVEL_SCU_START      5

// minimum battery level keeping scu running in %
#define POWER__MIN_BATTERY_LEVEL_SCU_RUN        0

#endif
