Geowissenschaften/EXCISS/(commit log)

2019-06-11 circuit diagrams and PCB design files
    [EXCISS HVU trigger.brd, EXCISS HVU.sch, EXCISS Mainboard.brd, EXCISS Mainboard.sch, EXCISS PSU.brd, EXCISS PSU.sch, EXCISS SEU.sch]
2021-05-23 mechanical design release
    [ANSI_4-40_UNC.ipt, DIN_963_M2,5x5.ipt, DIN_963_M3x5.ipt, DIN_963_M3x6.ipt, HVU.iam, HVU_1N4007.ipt, HVU_DC_DC_converter_(M1730CQEA06065).ipt, HVU_DIN_934_M3x0,5.ipt]
